yuiseki/exp-cubic-earth/simulate/README.md

# simulate

立方体の組み方を 3MF にして、3D ビューワーで見るためのスクリプト。寸法は `docs/DIMENSIONS.md`。

```sh
# 1. メーカーの STEP (ER-TFT040-3-6011.zip の中身) を、パネルと基板の STL に分ける (約 40 秒)
uv run --no-project --with gmsh --with numpy --with numpy-stl python step_parts.py ER-TFT040-3-6011.STEP

# 2. 2 つの山頂型モジュール (3 枚のパネルが 1 つの角に集まる形)で立方体を組み、合体と分解の 3MF を書く
uv run --no-project --with numpy --with numpy-stl python cube.py --fpc top=-y,A=-z,B=-z

# テスト
uv run --no-project --with numpy --with pytest python -m pytest -q test_geometry.py
uv run --no-project --with gmsh --with numpy --with numpy-stl --with pytest python -m pytest -q test_summit_frame.py
# 印刷用 STL (hardware/frame) が 1 つにつながった閉じた立体で、README の大きさと体積のとおりか
uv run --no-project --with numpy --with numpy-stl --with pytest python -m pytest -q test_frame_stls.py

# 3. 山頂型モジュールの Y 字の枠
uv run --no-project --with gmsh --with numpy --with numpy-stl python summit_frame.py
```

- 出力は `build/` (git に入れない。メーカーの 3D モデルから作った形を含むため)
- 1 つ目のモジュールは天面 (+z)、A (-y)、B (+x) の 3 面。2 つ目は同じモジュールを (1, 1, 0) の軸のまわりに半回転したもので、底面 (-z)、C (-x)、D (+y) になる
- `--fpc` は 1 つ目のモジュールの各面について、FPC の出る辺が向く方向 (世界の軸)。2 つ目は回転で決まる
- 面は FPC を折って基板をパネルの裏に重ねた状態 (基板は FPC の辺から 20mm)。FPC と FFC は箱で近似している。FFC は CON1 からパネルの辺の 2mm 先までを描く
- `--edge` を省くと、2 つの面の部品が重ならない最小の辺の長さ (向かい合うガラスの間) で組む。今は 6 面ともパネルの中心を立方体の中心から同じ距離に置くだけで、角で一方の面が他方の縁に重なる組み方はまだ入れていない
- 実行すると、各面の FFC がどの面の側へ出ていくかを表示する
- `cube.py --search` は、1 つ目のモジュールの 3 面の向き 64 通りについて、FFC の行き先、3 本とも自分のモジュールに留まるか、1 枚の面を角のまわりに 120 度ずつ回した形か (外から角を見て時計回りか反時計回りか)、最小の辺の長さ、FPC の辺 (ガラスの外に 2.81mm の縁がある辺) どうしが同じ稜に来る組の数 (`meetings`) を並べる。3 本とも留まるのは 8 通り、そのうち 120 度ずつ回した形は 2 通り (`top=-y,A=+x,B=+z` が時計回り、`top=-x,A=-z,B=+y` が反時計回り)。反時計回りの `top=-x,A=-z,B=+y` は、3 組とも FPC の辺がもう一方のモジュールの面の FPC の辺と同じ稜に来る (天面と C、A と底面、B と D)。時計回りの `top=-y,A=+x,B=+z` は 0 組だが、FFC がパネルの辺から出る所は角から約 57mm (反時計回りは約 25mm)。64 通りのうち 0 組は 20 通り
- `cube.py --module` は、1 つ目のモジュール (天面・A・B) だけを `build/module_<plan>.3mf` にも書く。立方体の筐体をモジュール単位で作るときの基準。角 (山頂) を真上に、FPC の辺がある縁を下にして立て、天面が手前 (-y) に傾く向き。いちばん低い点が z = 0 で、高さは約 88mm
- `summit_frame.py` は、山頂型モジュールの 3 本の継ぎ目 (天面/A、A/B、B/天面) に沿う、溝付きのまっすぐな棒 3 本を作る。棒の断面は L 字で、パネルごとにガラスの前の縁 (パネルの辺から `OVERLAP` = 1.0) と裏の壁 (`WALL_OVERLAP` = 3.0、厚み `BACK` = 1.2) があり、その間の溝 (2.18 + 両側 0.1 = 2.38) にパネルの辺が入る。2 本の溝が 90 度をなす。テープは使わず、前の縁だけでパネルを押さえる。山頂では 3 本が留め継ぎ (各点を、角から測ってより遠くまで伸びている継ぎ目の棒に入れる) で合わさる。モジュールは角のまわりに 1/3 回すと自分に重なるので 3 本は同じ形で、もう一方のモジュールも同じ。つまり 1 種類の棒を 6 本刷る。印刷は体積で課金され、Y 字につなぐと高さ 80mm ほどの印刷になるので、棒に分けて寝かせて刷る (82.7 x 7.5 x 7.5、1 本 1.96cm³)。基板・FPC・FFC の箱 (0.5 の余裕つき) は削ってある。FFC は継ぎ目まで行かずに内側へ折れる (実物で確認、2026-10-21) ので、CON1 からパネルの X = 68 まで進んで立方体の中心側へ 25mm 降りる箱で近似している。書くのは `build/summit_frame_bar<i>.step/.stl` (組んだ位置、立方体の中心が原点)、`build/summit_frame_bar0_print.stl` (縁の外の面を下に寝かせた 1 本)、モジュールの部品と合わせた `build/summit_frame_module_<plan>.3mf` (山頂を上)
- `cube.py --corner t,side,turn` は、各モジュールの角の内側に三角形の基板 (緑) を描く。対角線に垂直な正三角形で、3 枚のパネルの裏が出会う内側の角から t mm 中心寄り、一辺 side mm。turn = 0 で三角形の角がパネルどうしの継ぎ目 (FFC が出てくる所) を向き、turn = 60 で辺が継ぎ目を向く。厚みは基板 1.6 と部品 5.0 を中心側に取る。その位置で入る最大の大きさと、重なる部品を表示する (`corner_board.py`)
- `geometry.earth_turns(plan, face0="A")` は、各面に映す地球の面 (QSC の 0〜5、face0 の面から東へ 0〜3、天面が北極 4、底面が南極 5) と、その画像を時計回りに何回 90 度回すか (`lt7680_multi` の `x,n,r` の r) を返す。反時計回りの `top=-x,A=-z,B=+y` では 天面 (4,3)、A (0,0)、B (1,1)、底面 (5,2)、C (3,2)、D (2,3)
- 天面・A・B のモジュールに北極・アジア・アフリカを映すときは `face0="B"`: 天面 (4,2)、A (3,0)、B (0,1)、底面 (5,3)、C (2,2)、D (1,3)

## 溝のある棒と内側のコーナーブラケット (`summit_bars.py`)

山頂型モジュールの 3 本の継ぎ目に、溝のある角棒を 1 本ずつ通し、頂点の内側にコーナーブラケットを置く。透明な樹脂で印刷する前提。

```sh
uv run --no-project --with gmsh --with numpy --with numpy-stl python summit_bars.py
uv run --no-project --with numpy --with pytest python -m pytest -q test_summit_bars.py
```

- 棒は 6.88 x 6.88mm。断面に 2 本のスリット (幅 2.38mm、LCD 2.18mm に片側 0.1mm) があり、棒の中で交わらない。それぞれの LCD は外の面から 1.0mm 奥を通り、縁は相手の面から 4.38mm で止まる (くわえる深さ 2.5mm)。2 本のスリットの間に 1.0mm 残るので、棒は 1 本のまま。LCD の裏の壁は 1.2mm で、その先の内側の角は削る
- LCD は角で重ねない (風車にしない)。立方体の外の稜は、長いほうの LCD の辺 76.54mm に 4.38mm を 2 回足した 85.3mm
- 頂点では 3 本の棒の先端が斜め切り (どの点も、頂点から遠く伸びている継ぎ目の棒に属する) で合わさり、外の頂点を作る。3 本は同じ形
- コーナーブラケットは 3 枚の LCD の裏より内側だけにあり、外の面から 16mm までの立方体を、LCD の裏からの深さの和 26mm で四面体に切る。そこから棒の裏の壁を 0.1mm 太らせてくり抜くので、棒の端がブラケットのくぼみに収まる
- 組み方: 棒 3 本をブラケットに差す。そのあと LCD を 1 枚ずつ、その面の中で頂点に向かって斜めに押すと、2 本の棒のスリットに同時に入る
- 体積 (2026-10-28): 棒 1 本 2.48cm³、ブラケット 1.47cm³、1 モジュール約 8.9cm³。棒は外の面を下に寝かせて印刷する (`build/summit_bars_bar0_print.stl`)
- 出力: `build/summit_bars_bar<i>.stl/.step`、`build/summit_bars_bracket.stl/.step`、`build/summit_bars_module.3mf` (LCD と基板と並べたもの、頂点を上にして立てる)
- コーナージョイント (`joint_at`、`build/summit_bars_joint.stl`): 長い棒とブラケットの代わりに、頂点のまわりだけを押さえる 1 個の部品。3 本の棒を頂点から継ぎ目に沿って 20mm (`JOINT_ARM`) で切り、1 個につなげたもの。アクリルの十字コーナージョイント (3mm 板用) の立体交差版で、各腕に交わらない 2 本のスリットがある。1.43cm³、20mm 角に収まる。外の面を下に置いて印刷すると高さ 20mm
- 長い棒 (`long_bar_at`、`build/summit_bars_long_bar*.stl`): ジョイントの腕の先から継ぎ目の外周の端までの、同じ断面のまっすぐな棒。65.3mm、2.00cm³。腕と棒は突き合わせるだけで、LCD が両方のスリットを通るので向きがそろう。3 本は同じ形 (角のまわりに 3 分の 1 回すと移り合う、テストで確認)
- 採用した組み合わせはジョイント 1 個と長い棒 3 本 (1 モジュール約 7.4cm³)。LCD と並べたものが `build/summit_joint_module.3mf`
- 未決: モジュールどうしの継ぎ目 (外周の 6 本) と、棒の外周側の端の形

## 立方体全体の枠: 8 個のジョイントと 12 本の棒 (`cube_frame.py`)

`summit_bars.py` の断面のまま、8 個の頂点すべてにコーナージョイント (腕 20mm) を、12 本の稜すべてにジョイントの間の棒を置く。

```sh
uv run --no-project --with gmsh --with numpy --with numpy-stl python cube_frame.py
uv run --no-project --with numpy --with pytest python -m pytest -q test_cube_frame.py
```

- LCD は面の中央に置く。外の稜は長い辺 76.54mm に (4.38 + 0.1)mm を 2 回足した 85.5mm。長い辺はスリットの底の 0.1mm 手前、短い辺 (1.88mm 短い) は約 1mm 手前で止まり、くわえる深さは長い辺 2.4mm、短い辺 1.5mm
- スリットは LCD の大きさによらず、いつも底 (相手の面から 4.38mm) まで彫る。そのため棒 12 本は 1 つの形、ジョイント 8 個も 1 つの形で、どこに付けてもよい
- 枠が逃げるのは LCD の本体と基板だけ。FPC と FFC は曲がる配線なので、CAD では扱わない
- 体積 (2026-10-28): ジョイント 1.46cm³ x 8、棒 45.5mm 1.37cm³ x 12、全体 28.1cm³。どれも 1 個の固まりで閉じている (trimesh)
- 出力: `build/cube_frame_joint<n>.stl`、`build/cube_frame_bar<n>.stl` (立方体の中の位置)、印刷用に外の面を下に寝かせた `build/cube_frame_print/` (ジョイントは高さ 20mm、棒は 45.5 x 6.88 x 6.88mm)、LCD と並べた `build/cube_frame.3mf`
