yuiseki/exp-cubic-earth/tmp/HYPOTHESES.md

# 仮説の台帳 (ベイズ的に更新する)

対象の現象: 「パネル (ST7701S) の初期化は、動作中に命令として行うと高い確率で映る (37 回中 31 回、約 84%) のに、XIAO の起動時に同じ手順を行うと 1〜2 割しか映らず、電源の入れ直しでは 17:52〜18:11 の 3 回を除いて 11 回連続で映らない。」

確率は主観的な信念。観測ごとに、各仮説がその観測を予測していた度合い (尤度) で更新する。数値は粗い (0.1 刻み程度) が、方向と大きさを明示することが目的。

## 既知の観測 (TIMELINE.md より)

| 記号 | 観測 |
|---|---|
| O1 | LT7680 側は 17:07 以降一度も失敗していない |
| O2 | G の状態ではパネルへの命令 (反転、ソフトリセット、初期化) が届く |
| O3 | G からパネルに触らず XIAO をリセットすると 10/10 G のまま (XIAO 起動中 LT7680 はリセットされ、約 2 秒クロックが止まるのに) |
| O4 | 命令 #0 系 (LT7680 リセット 100ms → PLL/SDRAM → 表示オン → 塗り → SWRESET → 初期化) は 37 回中 31 回 G |
| O5 | 同じ手順を起動時に行う (ord 版) と 10 回中 1 回。8 秒待ってから行うと 11 回中 0 回 |
| O6 | V (LT7680 のリセット線を 1 秒浮かせ、LT7680 がでたらめにリセットされる → #0) は 8 回中 6 回 G |
| O7 | Y/Z (パネル SPI 線を 5 秒浮かせる。LT7680 は動き続ける) は 2/2 G のまま |
| O8 | 電源の入れ直し: 17:52、17:57、18:11 は G。以後 11 回は B (同一バイナリでも) |
| O9 | 焼き直しとリセットに差は見られない (19:54 焼き直し 5 回で G は 0) |
| O10 | P (白っぽく固まる) は電源の入れ直しでしか抜けない |
| O11 | D5 を入力にしてもパネルからの読み出しは無い (DIN は一方向) |

## 仮説と事前確率

| 記号 | 仮説 | 事前 | 根拠 |
|---|---|---|---|
| H_gap | 動作中のパネルが RGB クロックを長く (1 秒以上) 失った後は、ソフト初期化が通りにくく、失った時間が長いほど悪い。クロックを失うだけなら表示は保たれる (O3) が、その状態で初期化列を送ると壊れる | 0.30 | O4 (隙間 0.1 秒、84%) > O6 (約 1 秒、75%) > O5 (2〜5 秒、10%) > 8 秒版 (0%) と単調。O7 と矛盾しない |
| H_boot | XIAO の起動そのもの (ブートローダー中のピンの状態、USB 列挙の電流変動) がパネルを乱す | 0.20 | O5 と O9。ただし O7 (浮かせても壊れない) で弱い |
| H_por | 電源投入時のパネルの POR が電源の立ち上がり方で失敗する。電源の入れ直しの成否はファームと無関係 | 0.15 | O8 を説明。XIAO リセット時の挙動は説明しない |
| H_thermal | 基板かパネルが温まると初期化が通りにくくなる。成功が前半に集中 (O8、O4 の多くは 19:17 以前) | 0.15 | 時間による変化を説明。切り分けていない |
| H_initseq | 送っている初期化列やビットのタイミングが微妙に違い、確率的にしか通らない | 0.10 | 84% 通るので主因ではなさそう。vendorflow はメーカーと同じタイミング |
| H_other | 上記以外 | 0.10 | |

## 実験の計画と予測

| 実験 | 内容 | H_gap | H_boot | H_por | H_thermal | H_initseq |
|---|---|---|---|---|---|---|
| E1 | 命令 #G n: LT7680 をリセットに保ってクロックを n 秒止めてから #0 手順。n = 0.1, 1, 2, 4, 8 を数回ずつ。XIAO は再起動しない | n が長いほど失敗 | n に依らず約 84% | n に依らず約 84% | 温まっているなら全部低い | n に依らず一定 |
| E2 | E1 の n=2 と、esptool リセット (隙間約 2 秒 + XIAO 起動) を同じ回数比べる | 両方とも低い | リセットだけ低い | 両方高い | 両方低い | 両方同じ |
| E3 | 電源を 10 分以上切って冷ましてから入れる (本人の操作 1 回) | B (最近の 11 回と同じ) | B | B か G (確率) | G | B |
| E4 | 起動時の隙間を最小にする (delay(1500) を外し、起動直後に LT7680 を立ち上げる) でリセット ×10 | 改善 | 変わらない | 変わらない | 変わらない | 変わらない |

更新の記録は下に追記する。

## 更新 1: E1 の結果 (20:0x〜20:2x)

E1: G から始めて、LT7680 をリセットに保ちクロックを 0.1/1/2/4/8/16 秒止め、その後 #0 と同じ手順。14 試行中 14 試行 G (0.1 秒 ×4、2 秒 ×4、8 秒 ×3、16 秒 ×3)。XIAO は再起動していない。

副産物の観測 O12: リセット直後の動画で、B は「駆動されていない黒 (濃い青の画素 5,000〜9,000)」ではなく「同期は来ていて黒を表示している (約 21,000)」。パネルは RGB の同期を受け取っているが画素の値を無視して黒を出している。

| 仮説 | 事前 | 尤度 (E1) | 事後 |
|---|---|---|---|
| H_gap | 0.30 | 16 秒で 3/3 成功はほぼ起きない (約 0.05) | 0.03 |
| H_boot | 0.20 | 予測どおり (1.0) | 0.45 |
| H_por | 0.15 | 無関係 (0.5) | 0.17 |
| H_thermal | 0.15 | 3 時間稼働後に 14/14 なので低い (0.25) | 0.08 |
| H_initseq | 0.10 | 14/14 (0.15) | 0.03 |
| H_other | 0.10 | (1.0) | 0.24 |

H_boot の内訳 (次の実験で分ける):
- H_boot_pins: ブートローダー中にパネル SPI 線が浮き、その直後の初期化が失敗する → E5 (A: 3 本浮かせてから初期化) が失敗し、E6 (B: CS だけ High に保つ) が通る
- H_boot_usb: USB 再列挙に伴う 5V の揺れ → E7 (R: esp_restart、再列挙なし) が通る
- H_boot_rom: ROM が起動時にピンを駆動する → E7 が失敗し、E5/E6 が通る

## 更新 2: E5〜E12 (20:29〜21:16)

| 実験 | 内容 | 結果 |
|---|---|---|
| E5 (A) | パネル線 3 本を 5 秒浮かせてから初期化 | 通算 3/9 |
| E6 (B) | CS だけ High に保ち SCLK/DIN を浮かせてから初期化 | 2/4 |
| E7 (R) | esp_restart (USB 再列挙なし) で起動の流れ | 2/4 |
| E8 | B の状態で 0x13 NORON + 0x38 | 0/4 (全画素オフ/オン仮説は棄却) |
| E9 | #G0 (浮かせない) と #A を交互 | G0 5/5、A 2/5 (時間による劣化ではない) |
| E10 | 1 本だけ浮かせる: CS / SCLK / DIN | 3/3、1/3、3/3 (SCLK が原因) |
| E11/E12 | SCLK を浮かせた後の対策候補 | 対照 2/8、CS 上げ下げ 1/3、SWRESET x3 1/3、2 秒待ち 2/3、初期化列 2 回 8/8、SCLK 空打ち 1/3 |

結論 (信念 0.85): XIAO の起動中にパネル初期化用の SCLK (D4) が浮くと、その後の初期化列が 1 回では通らない (約 25〜35%)。初期化列を 2 回送ると通る (8/8)。機構は未解明 (CS は High なのに SCLK の浮きが効く。ソフトリセットでは直らない)。
電源投入時 (H_por) は未検証。起動の流れに「初期化列を 2 回」を入れた上で、電源の入れ直しで確かめる。

## 更新 3: 地球の描画と、起動の再検証 (21:17〜21:35)

判定器の訂正: 21:17 ごろからカメラの写りが変わり、黒いパネルが濃い青 (約 69) でなく薄い色 (約 145) で写るようになった。青の数の差で判定する `kwjudge.py` はこれ以後あてにならない (「LIVE」と言った kw-rec1 と e2-pre は、白の明るさで見ると 145 = 映っていない)。以後は白で塗った写真のパネル領域の明るさ (`wjudge.py`、映れば 220 以上、黒や固まった画面は 150 以下) で判定する。E8〜E12 の写真を明るさで見直したところ結果は変わらなかった (更新 2 の結論は有効)。

| 観測 | 結果 |
|---|---|
| O13 | `#0` (命令、初期化 1 回) で G にした後の `#E` で、地球の QSC の面が映った (earth-cmdE2-1792067074.jpg) |
| O14 | lt7680_earth の起動の流れ (初期化 2 回 → 地球) は、esptool リセット 0/5、esp_restart (#R) 0/3。シリアルは毎回 INIT OK、init twice、描画 4109 ms まで出る |
| O15 | 起動に失敗した直後の `#0` は 2/2 で G |

更新 2 の「初期化列を 2 回で通る (m4 8/8)」は、SCLK だけを浮かせた命令でのこと。本物の起動 (全部の線が浮く、バックライトが消えている、初期化直後に地球を描く) では 0/8。
E13: これらを命令 #F<v> で模倣して切り分ける (v のビット: 1=SCLK だけ浮かせる、2=バックライトは点けたまま、4=地球を描かない。F0 = 起動そっくり、F7 = m4 と同じ)。

## 更新 4: 起動の流れを 2 回 (21:38〜22:07)

| 実験 | 内容 | 結果 |
|---|---|---|
| E14 | 起動の条件を命令 #F<v> で模倣 (完了行を待ってから判定、15 秒後にも判定) | F0 1/2、F1 0/2、F2 2/2、F4 2/2、F7 1/2 (合計 6/10)。本物の起動 (0/8) ほど悪くない。判定が遅れて変わった例は無し |
| O16 | setup の先頭で IO_MUX を読んだ。リセット直後は D0〜D10 すべて wpu=0 wpd=0 (浮いている)。模倣の INPUT と同じ | H_pullup (リセット中は内蔵プルアップ) は棄却 |
| E15 flows2 | 起動時に「LT7680 リセット → PLL/SDRAM → 表示オン → 塗り → SWRESET + 初期化 ×2」の流れ全体を 2 回 | esptool リセット 10/10 |
| E15 flows2-init1 | 流れ全体 2 回、各流れのパネル初期化は 1 回 | 4/5 |

結論 (信念 0.9): XIAO の起動後、最初の流れ (LT7680 のハードリセットを含む) では映らず、2 回目の流れで映る。`#0` が 84% 通っていたのは、命令はいつも「2 回目以降の流れ」だったから。パネル初期化列を 2 回にするのは補助で、流れを 2 回にすることが本体。機構は未解明 (LT7680 の最初のリセット後に何かが安定していない、またはパネルの RST が LCM_RESET と共通で最初のリセットの効き方が違う、など)。
H_por (電源投入) は未検証。本人に USB-C の抜き差し 3 回を依頼する。

## 更新 5: 電源投入 (E16、2026-10-16 05:48〜05:55)

本人の報告: 流れ 2 回の版 (fb1c7cd) で USB-C の電源投入 3 回とも映らず。その数時間後に `#0` を送ると映った (LIVE)。

E16: 起動後 0、5、10、20、40、80 秒に流れを 1 回ずつ行い毎回白で塗る診断版で、本人が電源投入を 1 回。カメラの 2 秒ごとの撮影:
- 挿した 3 秒後 (最初の流れの完了直後) に白 (W=222) → 映った
- 5 秒の流れの途中 (LT7680 リセット) で暗くなり、以後 10/20/40/80 秒の流れを経ても黒のまま (W=73)
- シリアルは 6 回の流れとも lt7680 OK、reset reason 1 (power on)

| 観測 | 内容 |
|---|---|
| O17 | 電源投入では最初の流れで映る (1/1)。2 回目の流れが壊し、続く 4 回では戻らない |
| O18 | XIAO だけのリセットでは最初の流れで映らず 2 回目で映る (E15、10/10) |
| O19 | 流れ 2 回の版は電源投入で 0/3 (O17 と整合: 2 回目が壊す) |

当面の対処 (機構は未解明): reset reason が POR なら流れ 1 回、それ以外なら 2 回 (`BOOT_FLOWS_POWERON 1`、`BOOT_FLOWS 2`)。esptool リセットでは 2 回の経路が動くことを確認済み。電源投入 3 回の確認は本人に依頼。
「1 回目は映り 2 回目で壊れる」と「1 回目は映らず 2 回目で映る」を一つで説明する仮説は未着手。候補: 流れが状態を反転させる (偶奇) が、`#0` を G から送った 84% の観測と合わない。

更新 5 の追記: 流れ 1 回 (POR) の版でも本人の電源投入 3 回とも映らず (0/3)。E16 の「最初の流れで映る」は 1/1 で、再現しない。電源投入の正常系は未確立。

## 更新 6: 電源投入の直接測定 (E17〜E19、2026-10-16 06:00〜06:23)

- 映る状態と映らない状態で LT7680 のレジスタ 0x00〜0xFF を全部読み比べて完全に同一 (STSR も 0x50)。差は LT7680 の設定にはない
- E17/E18: 1 回流しの版での XIAO リセットが今日は 11/11 映る (昨夜は 0/8)。#y で映らない状態を作ってからリセットしても 3/3 映る。H_prev (前の状態が残る) は棄却。昨夜との違いは未特定
- E19 (電源投入、本人 1 回、診断版 0 秒と 30 秒に流れ、カメラ 2 秒ごと): 0 秒の流れも 30 秒の流れも黒のまま (E16 で見えた一瞬の白は再現せず)。LT7680 はリセット解除 4 ms で inhibit が落ち STSR=0x50。挿してから 133 秒後に `#0` を送ると映った (LIVE)
- 残る仮説: H_time (電源投入から約 2 分以上経てば流れが通る) と H_count (3 回目以降の流れが通る)。E20 の診断版 (0、3、6、9、150 秒に流れ) で分ける

## 更新 7: E20 (電源投入、本人 1 回、流れを 0/3/6/9/150 秒に)

挿してから 0、3、6、9 秒の流れはすべて黒。150 秒の流れで白 (挿してから 154 秒で W=218、以後持続)。LT7680 は毎回 4 ms で ready。
→ H_count (回数) は棄却。H_time (電源投入から約 2 分以上経つと流れが通る) を採用 (信念 0.8)。しきい値は 80 秒 (E16 で失敗) と 150 秒の間。
次: 流れを 150 秒に 1 回だけ (それまで LT7680 もパネルも触らない) で、「時間」だけで足りるのか、先行する流れ (クロックが出ている状態) が要るのかを分ける。

## 更新 8: 電源投入の自動運転 (E21〜変種 3、2026-10-16 06:33〜06:52)

本人の負担を減らすため、`cycle_runner.sh` で「ビルド → 焼く → ntfy で抜き差しを依頼 → 抜き差しを検知 → 200 秒間 2 秒ごとに撮影 → 最初に白くなった秒数を判定 → ntfy で結果」を自動化した。本人は ntfy が来たら抜き差しするだけ。

| 電源投入 | 起動後の操作 (秒) | 結果 |
|---|---|---|
| E16 | 流れ 0,5,10,20,40,80 | 全部黒 (最初の流れ直後に 1 コマだけ白、再現せず) |
| E19 | 流れ 0,30 → 133 秒に `#0` | 133 秒で映る |
| E20 | 流れ 0,3,6,9,150 | 150 秒で映る |
| E21 | 流れ 150 のみ | 黒 |
| 変種 1 thr | 流れ 0,60,90,120,150 | 全部黒 |
| 変種 2 ltonly | 0 秒は LT7680 だけ (PLL/SDRAM/表示オン/塗り、パネル初期化なし)、150 秒に流れ | 黒 |
| 変種 3 one150 | 流れ 0,150 | 151 秒で映る |

LT7680 は毎回リセット解除 4 ms で inhibit が落ち、STSR=0x50。流れの中の LT7680 側は常に正常。

### 仮説の更新

| 仮説 | 内容 | 判定 |
|---|---|---|
| H_count | 3 回目以降の流れが通る | 棄却 (変種 1 で 5 回目も黒) |
| H_time | 電源投入から約 2 分で流れが通る | 棄却 (E21、変種 2) |
| H_prev | 直前の状態が残る | 棄却 (E18) |
| H_pullup | リセット中の内蔵プルアップ | 棄却 (O16) |
| H_gap (LT7680 の連続稼働時間) | クロックが T 秒以上出ていれば通る | 棄却 (変種 2) |
| H_gap2 | 電源投入後、パネル初期化を含む流れを一度行い、その後 T 秒以上 (60 < T ≤ 103) 空けてから流れを行うと映る。間隔が短いと通らず、先行の流れが無いと通らない | 電源投入 7 回すべてと整合 (信念 0.75) |

H_gap2 で説明できないもの: XIAO だけのリセットでの挙動 (昨夜: 1 回流し 0/8、2 回流し 10/10。今朝: 1 回流し 11/11)。2 回流しの 2 回目は 200 ms 後なのに通る。電源投入と XIAO リセットでは別の機構が働いている可能性が高い。XIAO リセットの昨夜と今朝の差も未特定。

### 機構の候補 (未検証)

- パネルの RST が基板上で LCM_RESET と共通で、電源投入後の最初の SWRESET + 初期化列が ST7701S の何か (電荷ポンプ、ガンマ、バンク選択) を「半分だけ」進め、T 秒後の再初期化で完了する
- ST7701S の内部電源 (VCOM、AVDD) の立ち上がりが初期化列の後に完了し、完了前の再初期化は壊す

### 次の実験 (本人の選択待ち)

- A: T を詰める (流れ 0,120 → 0,90 → 良い方を 2 回再現)
- B: 150 秒で固定し、地球版 (流れ 0 → 150 秒 → 流れ → 地球描画) を作って再現 2 回

## 更新 9: H_gap2 (one150) の再現試験 rep150 (2026-10-16 06:55〜07:11)

条件: 同一バイナリ (58caab85、`-DBOOT_DIAG=1 -DBOOT_DIAG_AT=0,150000`)。cold boot (USB-C の抜き差し) → t=0 に流れ (LT7680 リセット → PLL/SDRAM → 表示オン → 白で塗る → SWRESET + 初期化列 ×2) → 150 秒間は LT7680 にもパネルにも何も送らない → t=150 秒に同じ流れ → 計測後に `#W` で白を塗り wjudge で判定 → LIVE のときだけ `#E` で地球を描いて撮影。ハード・配線・初期化列・SPI 速度・ピン設定は変更していない。`cycle_runner2.sh` が抜き差しを検知し、2 秒ごとに撮影した。

### 観測事実

| 試行 | USB 再接続 | reset reason | 流れ 1 (start → done, STSR) | 流れ 2 (start → done, STSR) | `#W` 後の W | 判定 |
|---|---|---|---|---|---|---|
| 1 | 06:55:41 | 1 (power on) | 1511 → 2638 ms, 0x54 | 150008 → 151135 ms, 0x54 | 204 (173 秒) | LIVE。地球を描いて撮影 (rep150-1/earth.jpg) |
| (2 初回) | 06:59:28 | 1 (power on) | 1511 → 2638 ms, 0x54 | 150008 → 151135 ms, 0x54 | 撮れず | 未判定 (Web カメラが 114 秒ごろ USB から消えた。rep150-2-unjudged/) |
| 2 | 07:04:13 | 1 (power on) | 1511 → 2638 ms, 0x54 | 150008 → 151135 ms, 0x54 | 83 (174 秒) | BLACK (全区間 W=83) |
| 3 | 07:07:32 | 1 (power on) | 1511 → 2638 ms, 0x54 | 150008 → 151135 ms, 0x54 | 83 (174 秒) | BLACK (全区間 W=83) |

- LIVE の試行 1 では、2 回目の流れの直後 (挿してから 163 秒の撮影) から白 (W=205) が持続した
- 3 試行とも LT7680 の挙動 (リセット解除 4 ms、流れの所要時間、STSR) は同一
- 結果: 1/3 (判定できた 3 回のうち 1 回)。同じ手順の変種 3 one150 (06:48) も含めると 2/4

### 判定 (事前に決めた基準)

1/3 なので、one150 は正常系の候補として弱い。しきい値 T の探索には進まない。

### 推測 (事実と分けて書く)

- 変種 3 と試行 1 の成功は、H_gap2 の「間隔 ≥ T」だけでは決まらない確率的な事象だった可能性が高い
- 別のエージェントの指摘 (150 秒待つ LCD の仕様は無い。ST7701S の RESX を XIAO から操作できず、電源投入時の RESX が保証されていない可能性) は、この結果と矛盾しない。ただし手元の資料に ER-PCBA5981-1 の回路図は無く、CON2 の 6 番 (パネル RST) が LCM_RESET と共通か、RC か、未接続かは未確認。メーカーのデモは LCM_RESET の HW_Reset しかしていないので、基板上で何らかの処理はされているはず
- 次に価値が高いのは、テスターで CON2 の 6 番と CON1 の 11 番 (LCM_RESET) の導通を 1 回確かめること (本人の操作)

## 更新 10: POR → 自己再起動 → 初期化 (selfrestart、2026-10-16 07:15〜07:21)

別エージェントの提案: cold boot ではパネルにも LT7680 にも触らず 2 秒待って esp_restart() し、2 回目の起動 (reset reason 3 = software) で通常の初期化を行う。本人の操作は USB-C を挿すだけ。
実装: `-DBOOT_POR_SELF_RESTART=2000`。2 回目の起動は既定の非 POR 経路 (流れ 2 回、昨夜の esptool リセットで 10/10 だった経路) → 地球描画 → バックライト。バイナリ ec4f3e76。判定は挿してから 40 秒後に `#W` → wjudge。

### 観測事実

| 試行 | USB 再接続 | reset reason | バックライト点灯 (W の変化) | `#W` 後の W | 判定 |
|---|---|---|---|---|---|
| 1 | 07:16:16 | 1 → 3 | 約 12 秒 | 84 (49 秒) | BLACK |
| 2 | 07:17:41 | 1 → 3 | 同様 | 黒 | BLACK |
| 3 | 07:19:30 | 1 → 3 | 同様 | 黒 | BLACK |

結果 0/3。自己再起動は 3 回とも起きている。撮影失敗なし。

### 推測

- 「XIAO の warm reset 後に初期化すれば通る」は cold boot には当てはまらない。昨夜 esptool リセットで 10/10 だったのは、パネルがそれ以前 (何時間も前) の電源投入から通電し続けていた状態での話
- 電源投入からの経過時間 (数秒) で決まる要素が残っていることと整合する。ソフトだけで制御できる変数は尽きつつある

## 2026-10-16 07:28: メーカーへの問い合わせ

本人が BuyDisplay (sales@buydisplay.com) に、ER-PCBA5981-1 の CON2 6 番 (パネル RST) の扱い (LCM_RESET との接続、RC/リセット IC/プルアップの有無)、推奨の電源投入とリセット手順、回路図の提供を問い合わせた。原文は tmp/email/ (非公開)。回答待ち。回答が来るまで RST 周りの推測は確定させない。

## 更新 11: lt7680_multi (流れ 2 回、POR の特別扱いなし) の cold boot (2026-10-16 08:05〜08:09)

本人が「今のファームで USB-C を挿し直すと地球が出る」と観測したため、同じバイナリのまま自動運転で 3 回。判定は挿してから約 49 秒後の `#W`。

| 試行 | 再接続 | `#W` 後の W | 判定 |
|---|---|---|---|
| 1 | 08:05:38 | 103 | BLACK |
| 2 | 08:06:58 | LIVE | LIVE (地球の写真あり) |
| 3 | 08:08:12 | LIVE | LIVE (地球の写真あり) |

観測事実: 2/3。手順は lt7680_earth の「流れ 2 回」(fb1c7cd、本人目視で 0/3) と同じ内容。
推測: 電源投入の成功率は 0〜2/3 の間で揺れており、ファームの違いより制御できていない変数 (電源の履歴、パネルの状態) の影響が大きい。「確実に出る」手順はまだ無い。

## 更新 12: メーカー回答 (2026-10-16 10:26 CST 受信)

### 事実 (メーカー回答と添付の基板図)

- CON2 6 番 (パネル RST) は RC リセット。R9 10kΩ が LT768_VDD3.3V (基板の 3.3V) と RST の間、C27 1µF が RST と GND の間。リセット IC やダイオードは図に無い
- LCM_RESET (CON1 11 番) とはつながっていない。マイコンから RST を操作する手段は無い
- 推奨手順: 電源投入後 20〜30ms 待って RC リセットの完了を待ち、それから ST7701S を初期化する

### 推測

- 時定数は 10ms。今のファームは初期化の開始が電源投入から数百 ms 以上後 (XIAO の起動 + LT7680 の初期化) なので、推奨の待ち時間は毎回すでに満たしている。待ち不足は cold boot の不安定の説明にならない
- 「RST が LCM_RESET と共通かも」は否定された。H_resx (RESX を操作できない) は事実になった
- 放電用ダイオードが無い RC リセットは、電源が完全に落ちきる前に再投入されると C27 が放電しきらず、RESX が十分に Low にならない (パネルの POR が不完全になる) ことがある。抜いている時間が試行ごとに違えば成功率の揺れを説明できる。ただし今の記録には抜いていた時間が無く、確かめていない
- 確かめ方 (ハードウェア変更なし): 抜き差しの検知で「抜けた時刻」も記録し、抜いている時間を短い (1 秒) と長い (30 秒以上) に分けて成功率を比べる

## 更新 13: メーカー推奨どおりの最小起動 (BOOT_MINIMAL、2026-10-16 20:09〜20:13)

条件: lt7680_multi を `-DBOARD_SELECT_DIRECT=1 -DBOOT_MINIMAL=1` でビルド (f4f6ab2、バイナリ f1ff9c1e)。setup の先頭でパネル線を固定し、millis() が 30ms になるまで待ち、LT7680 のリセットと初期化、ST7701S の初期化 1 回 (SWRESET なし)、表示オン、地球。順序はメーカーのデモ CTP_test.ino と同じ。追加の待ちと流れの繰り返しは無し。抜いていた時間は cycle_runner3.sh (pi5-deck でデバイスが消えてから戻るまで) で記録。

### 事実

| 試行 | 再接続 | 抜いていた時間 | LT7680 初期化 | パネル初期化 | STSR | `#W` 後の W | 判定 |
|---|---|---|---|---|---|---|---|
| 書き込み直後 (esptool リセット) | 20:09:24 | なし | | | | 104 | BLACK |
| 1 | 20:10:01 | 7.6 s | 30→243 ms OK | 243→425 ms | 0x54 | 105 | BLACK |
| 2 | 20:11:13 | 7.7 s | 30→243 ms OK | 243→425 ms | 0x54 | 105 | BLACK |
| 3 | 20:12:35 | 14.4 s | 30→243 ms OK | 243→425 ms | 0x54 | 107 | BLACK |

cold boot 0/3。millis() はアプリの開始からの時間で、電源投入からはこれに ROM とブートローダーの時間が加わる。

### 推測

- 「余計な待ちと繰り返しを捨ててメーカー推奨どおりにすれば cold boot が安定する」は否定された。RC リセットの完了 (20〜30ms) を待つことは満たしたうえで 0/3
- 抜いていた時間は 7.6〜14.4 秒あり、1µF を 10kΩ と基板の負荷で放電するには十分と考えられる。この 3 回については「C27 が放電しきらず POR が不完全」は説明にならない (短い抜き差しの比較はしていない)
- 1 回の初期化では通らず、繰り返すと通ることがある、というこれまでの傾向と整合する。パネルが初期化列を受け付ける状態に入る条件が、推奨手順の外にある

## 更新 14: パネル線の基板側プルの有無 (2026-10-16 20:3x、命令 #P)

### 事実

- 動作中に 1 本ずつ XIAO の内蔵プルダウン (約 45kΩ) とプルアップを掛けて読んだ。LCD_CS (D2)、LCD_SCLK (D4)、LCD_DIN (D5) とも、プルダウンで 0、プルアップで 1。内蔵プルに勝つ強さ (数十 kΩ 以下) の外部プルは基板側に無い
- O16 (setup 先頭の IO_MUX) と合わせると、電源投入から setup までの間、3 本とも電気的に浮いている (100kΩ 級の弱いプルの有無までは分からない)。LCD_CS の D2 は ESP32-S3 の GPIO3 (ストラップピン)

### 推測

- 別エージェントの仮説「パネルの RC リセット解除 (20〜30ms) の時点で LCD_CS が High と保証されていない」は前提として成り立つ
- ただし反対方向の観測もある: E6 (CS を High に保ち SCLK/DIN を浮かせる) 2/4、E10 (SCLK だけ浮かせる) 1/3。仕様上 CS が High なら SCLK は無視されるはずなのに、CS High でも SCLK の浮きが効いていた。CS のプルアップだけでは足りない可能性がある
- 検証にはハードウェアの変更 (外付けプルアップ) が要り、本人の方針 (配線を変えない) の判断が必要

## 2026-10-16 夜: 本人の観測

- 事実 (本人の目視): 今のファーム (lt7680_multi、流れ 2 回、850000e) で USB-C を抜き差しすると、3 回に 1 回くらい地球が出る
- 推測: 同じバイナリ・同じ手順で成否が分かれるので、決まった待ち時間や順序の不足ではなく、毎回変わるもの (浮いている線のノイズ、電源の立ち上がり方) で決まる、という見方と合う。更新 14 の「浮いた線と RC リセット解除の競合」はこの性質を説明できる候補の一つ

## 更新 15: 原因は LCD_CS の線が外れていたこと (2026-10-16 夜)

### 事実

- 本人が配線を確かめたところ、D2 には何も挿さっていなかった。ファームウェアと WIRING.md は D2 = LCD_CS (CON1 16 番) を前提にしていた
- D2 と CON1 16 番をつなぐと、USB-C の抜き差しで地球が 100% 映るようになった (本人の目視。回数は未記録)
- いつ外れたかは分からない (本人「配線をごちゃごちゃいじった後」)

### 推測

- パネルの CS が浮いていると、XIAO の初期化列が届くかどうかは CS の線が拾う電位次第になる。成否が毎回揺れたこと、2 回目の流れや繰り返しで通りやすかったこと、SCLK を浮かせると悪化したこと (CS が実際には High でなかったため SCLK の雑音がそのまま取り込まれた) は、これで説明できる
- 更新 1〜14 の数字と結論 (流れ 2 回、150 秒、RC 放電、競合仮説など) は、外れていた期間にどこまで重なるか分からないので、根拠として使わない。#P の「LCD_CS に外部プル無し」も、線がつながっていない状態で測ったもので、基板側の事実としては無効
- 教訓: 電気的に説明しにくい揺れが出たら、仮説を重ねる前に、実物の配線を本人と 1 本ずつ照合する

- 追記 (本人の目視): LCD_CS をつないだ状態で、lt7680_multi の既定ビルド (流れ 2 回) の USB-C 抜き差しは 5/5 で地球が映った
- 追記: LCD_CS をつないだ状態で BOOT_MINIMAL (dac32ded) を cold boot。自動判定 3/3 LIVE (W=202〜204、抜いていた時間 2.2/3.2/4.7 秒、パネル初期化はアプリ開始から 243〜425ms)。本人の目視でも全回映った。4、5 回目の自動判定は本人の確認で足りたので打ち切った。更新 13 の BOOT_MINIMAL 0/3 は LCD_CS が抜けていたため

## 更新 16: 画素のバースト 10MHz の再試験 (2026-10-16 20:46〜、LCD_CS 接続済み)

- 事実: `-DBOOT_MINIMAL=1 -DPIXEL_SPI_HZ=10000000` (142154ee) を esptool リセットで起動。`#E` (10MHz で地球) → `#W` (白) を 10 回、白の判定 10/10 LIVE (W=202〜205)、地球の書き込みは毎回 776 ms (1MHz では約 4.1 秒)。写真の地球に色化けは見えない。本人も「描画がめちゃくちゃ早くなった」と目視
- 推測: 10/15 の「10MHz でパネルが止まる」は LCD_CS が抜けていたための揺れを 10MHz のせいと取り違えたもの。776 ms で 10 倍にならないのは、64 バイトごとに 1MHz で状態を読んでいるため

## 更新 17: 20MHz と全画素の照合 (2026-10-16 20:52〜21:15)

### 事実

- 20MHz (fbb65394): 地球の書き込み 588 ms、`#E`→`#W` 10 回で白 10/10 LIVE。写真に化けは見えない
- 命令 `#V` (表示用メモリを全画素 1MHz で読み返して照合、14.9 秒) を追加。20MHz で書いた直後 8 画素が不一致、すぐ読み直すと 24
- 命令 `#S<MHz>` で画素の速さを切り替え、`#K`→`#E`→`#V`→`#V` を比べた: 1MHz 23→40、10MHz 18→40、20MHz 18→39。不一致はどれも 1 ビットが 0→1 (0x0200、0x0400、0x4000 など上位バイト)、同じ位置が繰り返し出る
- `#V` を続けると 45、51、54、61 と増えた
- SDRAM のリフレッシュ間隔を LCD.cpp と同じ 486 (以前は 0x61A = 1562) にしても、6→26→34→41→45→53 と同じように増えた
- 書いてから 90 秒何も読まずに置いて読むと 7、続けて読むと 28

### 推測

- SPI の速さは化けと関係ない。20MHz の書き込みは 1MHz と同じ品質
- 化けを増やしているのは時間ではなく読み返し。最初の 6〜8 も、同じ読み返しの途中で起きている可能性があり、書き込みが完全かどうかはこの方法では確かめられない
- リフレッシュ間隔の仮説は棄却。値はメーカーに合わせた 486 のまま残す (効果は観測されていない)
