yuiseki/exp-cubic-earth/hardware/frame/bar-deep.stl

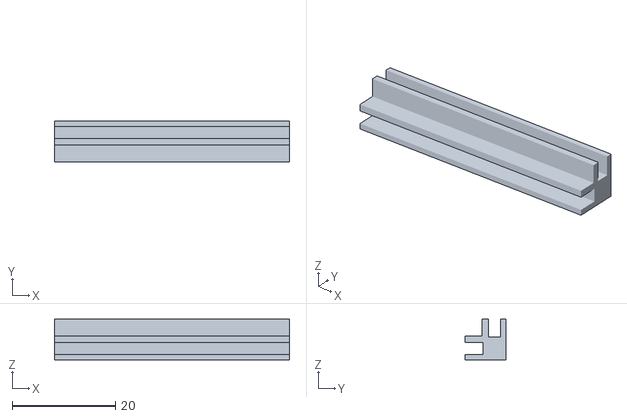
[picture p1: CAD file, 2026-11-08]
hardware/frame/bar-deep.stl
45.5 x 7.88 x 7.88
