yuiseki/exp-cubic-earth/hardware/frame/joint-deep.stl

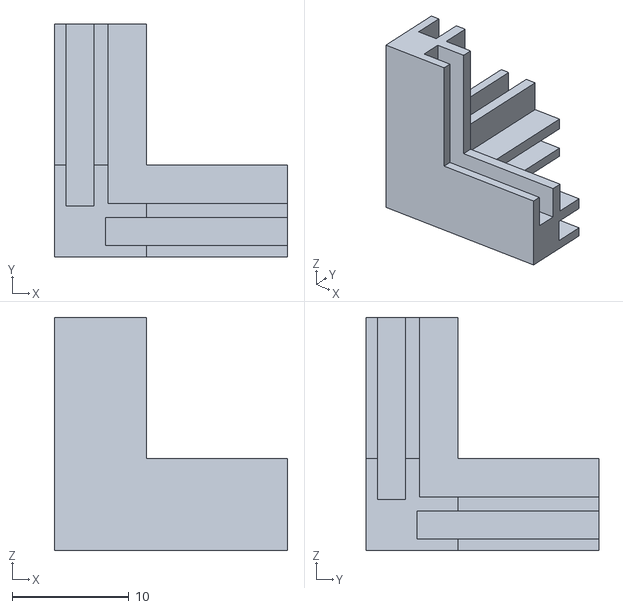
[picture p2: CAD file, 2026-11-08]
hardware/frame/joint-deep.stl
20.0 x 20.0 x 20.0
