yuiseki/exp-cubic-earth/hardware/frame/joint.stl

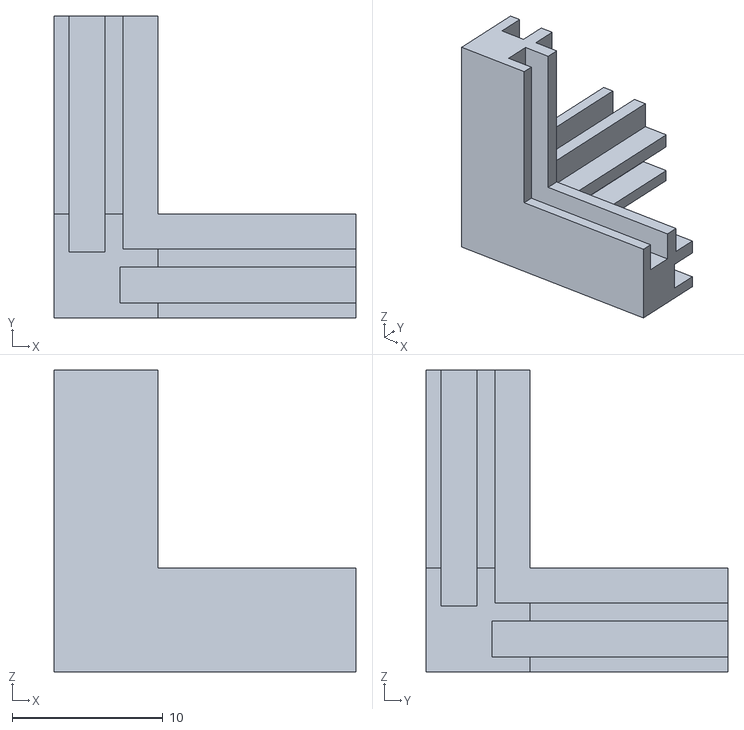
[picture p3: CAD file, 2026-10-28]
hardware/frame/joint.stl
20.0 x 20.0 x 20.0
