yuiseki/exp-cubic-earth/hardware/frame/bar.stl

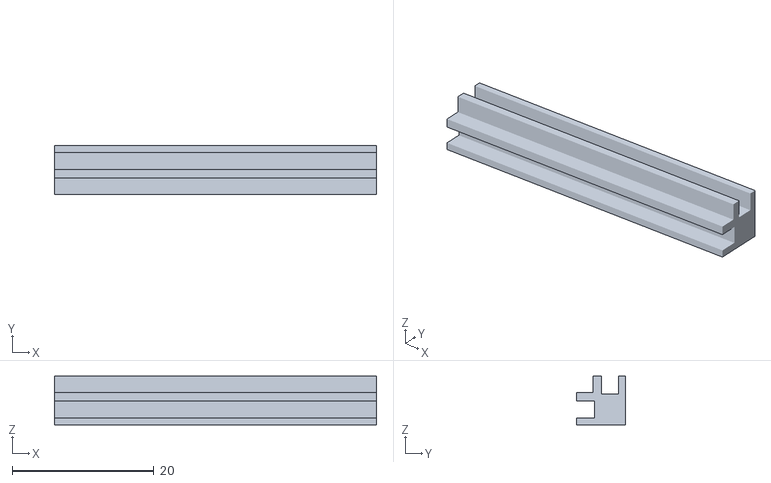
[picture p4: CAD file, 2026-10-28]
hardware/frame/bar.stl
45.5 x 6.88 x 6.88
