yuiseki/exp-cubic-earth/WIRING.md

# 配線: XIAO ESP32-S3 と ER-PCBA5981-1 (LT7680A-R) + ER-TFT040-3

動いている構成は 3 つある。どれも USB-C を挿すたびに地球が映る。

| | 構成 1: 直結で 1 枚 | 構成 2: 74HC138 で 2 枚 | 構成 3: 74HC138 で 3 枚 |
|---|---|---|---|
| 枚数 | 1 | 2 | 3 |
| CS の出し方 | XIAO の D0、D2 から直接 | XIAO の D0/D2/D6 で TC74HC138AP の番地を選び、その出力を CS に | 構成 2 と同じ。74HC138 の出力を 2 本足す |
| ファーム | `lt7680_multi` を `-DBOARD_SELECT_DIRECT=1` で (`lt7680_earth` も同じ配線) | `lt7680_multi` を `-DNUM_BOARDS=2` で | `lt7680_multi` を `-DNUM_BOARDS=3` で |
| 電源投入から全部映るまで | 約 1 秒 | 約 1.8 秒 | 約 2.6 秒 |
| 確認 | 2026-10-16 | 2026-10-18 | 2026-10-18 |

ビルドと命令は `lt7680_multi/README.md`。

## 共通

### 経路

XIAO ESP32-S3 (Sense でないもの) → デュポン線 → 変換基板「FPC-20P 1.0MM / 0.5MM」の 2x10 ピンヘッダ → 1.0mm 20 ピン FFC → ER-PCBA5981-1 の CON1 → (基板上の CON2 の FPC) → ER-TFT040-3

変換基板のピンヘッダの番号と CON1 の番号は、そのまま一致する (変換基板 j 番 = CON1 j 番)。

### どちらの構成でも XIAO から直接つなぐ線

2 枚以上のときは、全基板の同じ番号どうしをつないで共有する (CON1 の 1〜4、6〜9、11、18、19)。

| XIAO | CON1 | 信号 | 用途 |
|---|---|---|---|
| GND | 1, 2 | GND | |
| 5V | 3, 4 | VDD | 基板の電源 (動作範囲 3.3 から 5.0V)。基板上で 3.3V を作る |
| D9 (MISO) | 6 | LCM_SDO | LT7680 の SPI |
| D10 (MOSI) | 7 | LCM_SDI | LT7680 の SPI |
| D8 (SCK) | 8 | LCM_SCLK | LT7680 の SPI |
| D3 | 9 | BL_CONTROL | バックライト (出荷時の J1 短絡で外部信号が点灯を制御) |
| D1 | 11 | LCM_RESET | LT7680 のリセット。open drain + XIAO の内蔵プルアップ |
| D5 | 18 | LCD_DIN | パネル (ST7701S) の初期化用 3 線 SPI のデータ |
| D4 | 19 | LCD_SCLK | パネルの初期化用 3 線 SPI のクロック |

残りの CON1 5 番 (LCM_SCS、LT7680 の SPI の CS) と 16 番 (LCD_CS、パネルの初期化用 SPI の CS) のつなぎ方が、構成ごとに違う。

### パネルのリセット

パネルの RST (CON2 の 6 番) は CON1 に出ていない。基板上の RC リセット (R9 10kΩ で基板の 3.3V へ、C27 1µF で GND へ) だけにつながっていて、電源投入から 20〜30ms で解除される (メーカー回答)。XIAO から操作する線は無い。

### 起動の手順

メーカー推奨どおりで映る: 電源投入から 30ms 以上待つ → LT7680 のハードリセットと初期化 (PLL、SDRAM、表示タイミング) → ST7701S の初期化列を 1 回 → LT7680 の表示オン → 描画。`lt7680_multi` の既定の起動がこの手順で、2 枚のときは LCM_RESET を全基板一度に出したあと、基板ごとに初期化から描画までを順に行う。

## 構成 1: XIAO ESP32-S3 直結で 1 枚

共通の表に、CS の 2 本を足す。

| XIAO | CON1 | 信号 |
|---|---|---|
| D0 | 5 | LCM_SCS |
| D2 | 16 | LCD_CS |

D6、D7 は空き。電源投入から地球まで約 1 秒。USB-C の抜き差しで 4/4 映った (2026-10-16 夜)。

## 構成 2: XIAO ESP32-S3 + 74HC138 で 2 枚

CS の 2 本を XIAO から直接でなく、3 to 8 デコーダー TC74HC138AP (DIP-16) の出力でつなぐ。XIAO が出す 3 ビットの番地で、8 本の出力のうち 1 本だけが Low になる。出力は負論理なので、そのまま CS につなげる。

### XIAO → TC74HC138AP

| XIAO | TC74HC138AP | |
|---|---|---|
| D0 | 1 (A) | 番地の bit 0 |
| D2 | 2 (B) | 番地の bit 1 |
| D6 | 3 (C) | 番地の bit 2 |
| GND | 4 (G2A)、5 (G2B)、8 (GND) | |
| 3.3V | 6 (G1)、16 (VCC) | |

### TC74HC138AP → 基板

| TC74HC138AP | つなぐ先 | 番地 (CBA) |
|---|---|---|
| 15 (Y0) | 基板 0 の CON1 5 LCM_SCS | 000 |
| 14 (Y1) | 基板 1 の CON1 5 LCM_SCS | 001 |
| 12 (Y3) | 基板 0 の CON1 16 LCD_CS | 011 |
| 11 (Y4) | 基板 1 の CON1 16 LCD_CS | 100 |
| 7 (Y7) | 未接続 | 111 (どれも選ばない、待機時) |

3 枚にするときは構成 3。

### この構成で確かめたこと (2026-10-18)

- 2 枚とも LT7680 が応答し、電源投入から 2 枚目の地球まで約 1.8 秒。USB-C の抜き差しで 3/3、2 枚ともすぐに映った
- LCM_SDO (MISO) を 2 枚で共有しても、状態の読みは化けなかった
- 片方を白・片方を黒に塗って入れ替えると入れ替わる (2 枚を別々に選べている)
- 電源は XIAO の USB から 2 枚分。余裕は測っていない

## 構成 3: XIAO ESP32-S3 + 74HC138 で 3 枚

構成 2 の配線に、基板 2 への 2 本を足す。基板 2 の CON1 のほかの線 (共通の表の 9 本) は、基板 0、1 と共有する。

| TC74HC138AP | つなぐ先 | 番地 (CBA) |
|---|---|---|
| 15 (Y0) | 基板 0 の CON1 5 LCM_SCS | 000 |
| 14 (Y1) | 基板 1 の CON1 5 LCM_SCS | 001 |
| 13 (Y2) | 基板 2 の CON1 5 LCM_SCS | 010 |
| 12 (Y3) | 基板 0 の CON1 16 LCD_CS | 011 |
| 11 (Y4) | 基板 1 の CON1 16 LCD_CS | 100 |
| 10 (Y5) | 基板 2 の CON1 16 LCD_CS | 101 |
| 7 (Y7) | 未接続 | 111 (どれも選ばない、待機時) |

Y6 (9 番) は空き。74HC138 の出力は 8 本なので、この割り当て (基板ごとに 2 本、待機に 1 本) では 3 枚が上限。

### この構成で確かめたこと (2026-10-18)

- USB-C の抜き差しで 3/3、3 枚ともすぐに映った (本人の目視)
- 3 枚とも、状態を 40 回読んで 40 回正しい値 (STSR=0x54、CCR=0xC8、DPCR=0x40)。MISO を 3 枚で共有しても化けない
- 電源は XIAO の USB から 3 枚分 (バックライト込み) で動いている。XIAO の起動理由に電圧低下 (brownout) は出ていない。基板側の 5V は測っていない
- つないだ直後は基板 2 だけ不安定だった (下の「はまったところ」)。配線を確かめ直したあとは再現していない

## はまったところ

- 3 枚目 (基板 2) をつないだ直後、基板 2 だけ起動時に LT7680 の初期化が「表示用メモリ準備完了」待ちで止まり、映らなかった。基板 2 の状態の読みは毎回ばらばらで、CCR (書いたら変わらないはずのレジスタ) まで 0xC1、0xC8、0xC9 と変わった。バックライト (D3) を消すと基板 2 だけリセット直後の値 (STSR=0x00、CCR=0xC1、DPCR=0x00) に戻り、点けると戻った。レジスタの SPI を 100kHz まで落としても変わらなかったので、信号の速さの問題ではない。本人が基板 2 の CON1 9、11、1、2 番を確かめ直したあと (配線の変更は無し) は再現しなくなった。どの接触が効いたかは切り分けていない。同じ症状が出たら、まずその基板の線を 1 本ずつ挿し直す。`#I` (選んだ基板だけ初期化し直す) で一時的には戻せる
- LCD_CS (D2 ↔ CON1 16 番) が抜けていても、LT7680 は普通に動き、パネルも 3 回に 1 回くらいは映る。2026-10-16 夜まで、これに気付かず電源投入の不安定を調べていた。パネルが映ったり映らなかったりしたら、まずこの線を確かめる。
- パネル初期化用の LCD_DIN と LCD_SCLK を、LT7680 の MOSI (D10) と SCK (D8) に相乗りさせると、パネルは真っ黒のままだった。別のピンに分けると映った。メーカーのデモ (ER-TFT040-3_ESP32_Tutorial) も別のピンにつないでいる。UART0 の D6/D7 は避けて D4/D5 にした。
- LCM_RESET には基板にプルアップが無い。線が浮くとノイズを拾い、LT7680 がほとんどの時間リセットされたままになる。XIAO の内蔵プルアップで High に保ち、オープンドレインで Low に引く。LT7680 自身もこのピンにリセットを出す (オープンコレクタ) ので、High を押し付けない。
- XIAO ESP32-S3 Sense では、D9 (MISO) が何をしても High に張り付いた。拡張ボードの microSD が D8/D9/D10 を共有しているためと考えられる。本体の回路図 (`202003753_XIAO ESP32S3 Sense_v1.5`) では、拡張ボードへの基板間コネクタ J3 (DF40C-30DP) の 2〜5 番に D2、D8 (SCK)、D9 (MISO)、D10 (MOSI) が出ていて、「SD Card」と書かれている。拡張ボードの回路図 (`XIAO_ESP32S3_ExpBoard_v1.0_SCH.pdf`、Seeed の wiki の「XIAO ESP32S3 Sense オープンソース資料」) では、microSD の CS は R12 (0Ω、実装) で GPIO21 (USER_LED) につながり、D2 へは R11 (DNP、未実装) なので D2 にはつながっていない。MISO、MOSI、CS には 4.7kΩ の引き上げ (JP3 経由で microSD 用の 3.3V へ)、MISO、SCK、MOSI には 22Ω の直列抵抗がある。CS が GPIO21 で別なので、回路の上では LT7680 と SPI を共有して使えるはずだが、上の「D9 が High に張り付いた」はこの回路図だけでは説明できず、原因は分かっていない。Seeed の wiki (`xiao_esp32s3_sense_filesystem`) は「microSD を使うと XIAO の SPI は同時に使えない」とし、拡張ボードの J3 のはんだパッドを切ると microSD が無効になる (出荷時はつながっていて有効) と書いている。回路図の JP3 は 4.7kΩ の引き上げの電源側にあり、wiki の J3 と同じものかは未確認。2026-10-20、Sense (拡張ボード付き、microSD カード無し) に `lt7680_multi` (構成 3) を焼くと、起動時に基板 0 と 1 の LT7680 が「表示用メモリ準備完了」を待ったまま (10 秒待っても) 来ず、基板 2 は通った (4 回中 4 回、0 と 1 のどちらかか両方)。起動後に `#I` で初期化し直すと通った。拡張ボードを外して USB-C を挿し直すと、リセット 3 回で 3 枚とも通った。拡張ボードを付け直して USB-C を挿し直しても、リセット 3 回で 3 枚とも通った (1 回だけ基板 0 で準備完了まで 191ms 待った。普段は 100ms 未満)。拡張ボードそのものは原因ではなさそうで、最初の失敗は配線の接触か、焼き替えた直後の電源の状態によるものと考えられるが、どれかは分かっていない。Sense でない XIAO を使う。
- FFC の接点の向きが変換基板か CON1 のどちらかで合っていないと、どこにも接触しない。そのとき LT7680 は無応答で、MISO は浮く。片側を裏返したら接触した。
- 接触しても GND が来ていない間は、信号線を High にするとチップの保護ダイオード経由で基板の電源の網と GND の網が持ち上がる。基板の GND (JP1 の 1 番) が XIAO の GND に固定されるのを確かめてから 5V をつなぐ。
- 線を足したときに D10 が緩み、LT7680 の書き読みが周波数に関係なくでたらめに化けた。値が化け始めたら、まず配線の緩みを疑う。
- 2026-10-15 に「画素を 10MHz で大量に送るとパネルが止まる」と見えたのは、LCD_CS が抜けていた時期の観測だった。つないだ状態では、画素のバーストを 10MHz にしても止まらない (地球の全面書き込みと白塗りを 10 回繰り返して 10/10、2026-10-16)。

## LT7680 の SPI について確かめたこと

- モード 3 (データシートの図 2-4)。モード 0、2、3 は 100kHz と 1MHz で書き読みが通り、モード 1 は通らなかった。
- 1 回の転送は 16 クロック。先頭 8 ビットが前置き (0x00 レジスタ番号を書く、0x80 データを書く、0x40 状態を読む、0xC0 データを読む)。
- 起動直後の STSR は 0x50 (書き込み FIFO 空、読み出し FIFO 空、通常動作、表示メモリは未初期化)。

## 網の確かめ方

`netfinder` で、ADC の D5 を基板上の網 (JP1 の穴) にクリップし、XIAO の各ピンを 1 本ずつ動かす。全部 High にして 1 本だけ Low にしたとき 0V まで引き下げられるピンが、その網に直結しているピン。

## JP1 の穴の並び

JP1 は CON2 側の角にある 7 個の穴。基板の縁に沿った 5 個が、角から 7、6、5、3、1。内側の 2 個は 4 と 2 で、3 と 1 の隣にある。1 番が VSS、6 番が 3.3V、7 番が LCM_RESET。
