yuiseki/exp-cubic-earth/hardware/hub3/hub3.kicad_pcb

## KiCad design hardware/hub3/hub3.kicad_pcb (2026-10-23)

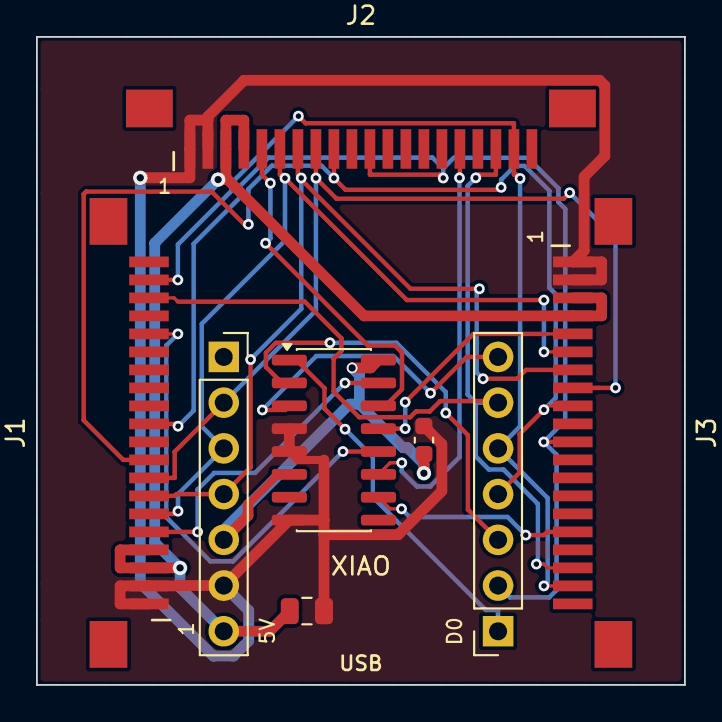
[picture p5: board hub3.kicad_pcb from above]

Board: 2 copper layers, 36.0 x 36.0 mm, 9 parts (0 on the bottom side), 19 nets.

Parts:
C1: 100nF; C_0603_1608Metric
C2: 10uF; C_0805_2012Metric
J1: LCD0; FFC_1.0mm_20P_Bottom_C132515
J2: LCD1; FFC_1.0mm_20P_Bottom_C132515
J3: LCD2; FFC_1.0mm_20P_Bottom_C132515
J4: XIAO D0-D6; PinSocket_1x07_P2.54mm_Vertical
J5: XIAO D7-5V; PinSocket_1x07_P2.54mm_Vertical
U1: 74HC138; SOIC-16_3.9x9.9mm_P1.27mm
X1: XIAO; XIAO_ESP32S3_Outline

Connections:
+3V3: C1.1, J5.5, U1.6, U1.16
+5V: C2.1, J1.3, J1.4, J2.3, J2.4, J3.3, J3.4, J5.7
BL_CTRL: J1.9, J2.9, J3.9, J4.4
GND: C1.2, C2.2, J1.1, J1.2, J2.1, J2.2, J3.1, J3.2, J5.6, U1.4, U1.5, U1.8
LCD_CS0: J1.16, U1.12
LCD_CS1: J2.16, U1.11
LCD_CS2: J3.16, U1.10
LCD_DIN: J1.18, J2.18, J3.18, J4.6
LCD_SCLK: J1.19, J2.19, J3.19, J4.5
LCM_RESET: J1.11, J2.11, J3.11, J4.2
LCM_SCLK: J1.8, J2.8, J3.8, J5.2
LCM_SCS0: J1.5, U1.15
LCM_SCS1: J2.5, U1.14
LCM_SCS2: J3.5, U1.13
LCM_SDI: J1.7, J2.7, J3.7, J5.4
LCM_SDO: J1.6, J2.6, J3.6, J5.3
SEL_A: J4.1, U1.1
SEL_B: J4.3, U1.2
SEL_C: J4.7, U1.3
