yuiseki/exp-cubic-earth/(commit log)

2026-10-15 Bring up LT7680A-R and an ST7701S 480x480 panel from a XIAO ESP32-S3
    Probes and bring-up sketches for the large cubic-earth display:
    LT7680 SPI probe, net finder for the breakout's FFC wiring, LT7680
    PLL and SDRAM init, and a colour-bar test that lights the
    ER-TFT040-3 panel through an ER-PCBA5981-1 controller board.
    WIRING.md records the confirmed wiring and what went wrong on the way.
    Claude-Session: https://claude.ai/code/session_01QQqL2MiTqB6ZDq8JiNUdWg
    [lt7680_backpower.ino, lt7680_bootprobe.ino, lt7680_colorbar.ino, lt7680_init.ino, lt7680_probe.ino, lt7680_vendor.ino, netfinder.ino]
2026-10-15 Fill the display RAM with solid colours through the LT7680 draw engine
    lt7680_fill sets up the main window, canvas and active window as the
    vendor demo does, then fills the whole 480x480 screen with red, green,
    blue, white and black in turn. Each full-screen fill takes about 3 ms.
    All five colours appeared in the right order on the panel.
    lt7680_vendor drives the panel init lines on D6/D7, separate from the
    LT7680 SPI bus, which is what made the colour bar appear.
    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
2026-10-15 Write pixels into the LT7680 display RAM in bursts and read them back
    lt7680_pixels draws a full-screen test pattern through the memory data
    port, sending one 0x80 prefix followed by 64 bytes at a time. That is
    about 30 times faster than the vendor demo's prefix-and-CS per byte.
    A few pixels are read back and compared with the pattern.
    At 10 MHz the panel stopped showing anything and stayed black until a
    power cycle, even after an ST7701S software reset. At 1 MHz it keeps
    working, so the pixel clock stays at 1 MHz for now (4.1 s per screen).
    The panel init now starts with a page-0 select and a software reset.
    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
    [lt7680_pixels.ino]
2026-10-15 Initialise the panel only on power-on, and add a serial command shell
    lt7680_shell takes one-letter commands after a '#' (reset and init the
    LT7680, init or soft-reset the panel, invert, fill, backlight, status).
    Commands need the '#' so that a host tty echoing the board's own output
    cannot trigger them, which happened when the port was reopened.
    Re-sending the ST7701S init to a panel that is already running, after a
    XIAO-only reset, often left it black (recoverable by a soft reset and
    init while the LT7680 drives pixels) or stuck on a pale frame that took
    no commands until a power cycle. The shell now sends the panel init only
    when esp_reset_reason() is power-on. With the panel left alone,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
    [lt7680_fill.ino, lt7680_pixels.ino, lt7680_shell.ino]
2026-10-15 Record that the panel does not come up reliably, and add the vendor-flow sketch
    lt7680_vendorflow copies the vendor demo's setup() and loop() (PLL,
    SDRAM, timing registers, ST7701S init, display on, colour fills) with
    only the pin assignment, a 1 MHz SPI clock and the backlight pin
    changed. It still showed nothing on 4 of 4 power cycles and 5 of 5
    XIAO-only resets, after one flash that did come up.
    lt7680_shell gained commands for the experiments (float lines, wait
    between LT7680 and panel init, fill black/white for camera checks) and
    now waits 8 s after boot before initialising, which did not help.
    WIRING.md records what was tried, what made no difference, and the
    camera-based check used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
    [lt7680_shell.ino, lt7680_vendorflow.ino]
2026-10-15 Draw a QSC earth face on the panel, and send the panel init sequence twice at boot
    Experiments E1-E12 (tmp/HYPOTHESES.md) showed that when the panel SCLK
    line floats during the XIAO bootloader, a single ST7701S init sequence
    afterwards only takes about a third of the time; sending it twice took
    8/8. lt7680_earth builds on the shell with that boot flow and a `#E`
    command that streams a 480x480 RGB565 QSC face through the memory data
    port. lt7680_panelread confirms LCD_DIN is write-only on this breakout.
    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
2026-10-15 Run the whole LT7680-to-panel init flow twice at boot
    After a XIAO reset the first flow (LT7680 hard reset, PLL/SDRAM,
    display on, fill, ST7701S SWRESET + init) never brought the panel up
    (0/8), while the same flow issued later as a serial command did about
    80% of the time. Running the flow twice at boot came up 10/10 across
    esptool resets; the doubled panel init inside each flow is secondary
    (4/5 with a single init). BOOT_FLOWS and BOOT_PANEL_INITS control it.
    Also adds the #F0-#F7 boot-mimic commands and a boot-time IO_MUX dump
    used to rule out reset-time pull-ups.
    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
    [lt7680_earth.ino]
2026-10-15 Add docs/STATUS.md with the verified facts, and use one boot flow on power-on
    docs/STATUS.md lists only what has been confirmed: wiring, what the
    LT7680 and ST7701S paths do, the earth face rendering, tooling, and the
    measured boot success rates. Power-on still does not come up reliably
    with either one or two boot flows (0/3 each, observed by the owner);
    the reset-reason switch stays in as the current best guess.
    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
    [lt7680_earth.ino]
2026-10-15 Log the one150 reproducibility test: 1/3 on cold boot, not a boot sequence candidate
    Same binary, cold boot, one init flow at t=0, 150 s of silence, the
    same flow at t=150 s: LIVE 1/3 (one further trial unjudged because the
    webcam dropped off USB). The LT7680 side was identical in every trial.
    Per the pre-set rule, no threshold search follows. Also adds flow
    start/STSR logging to the diag boot path and a configurable schedule.
    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
2026-10-15 Try a POR self-restart before panel init: 0/3 on cold boot
    On power-on the firmware now optionally waits 2 s, calls esp_restart()
    and runs the normal two-flow init on the software reset
    (BOOT_POR_SELF_RESTART). Three cold boots all stayed black although
    the restart happened each time, so a warm reset of the XIAO alone does
    not make the ST7701S init take right after power-on.
    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
    [lt7680_earth.ino]
2026-10-15 Add lt7680_multi: board-selection abstraction for driving several panels
    Carries the LT7680/ST7701S driver from lt7680_earth and routes every
    chip select through selectLine(), with two wirings: the current direct
    one (LCM_SCS on D0, LCD_CS on D2) and a 74HC138 decoder (A0-A2 on
    D0/D2/D6, Y0-Y2 = LCM_SCS, Y3-Y5 = LCD_CS, Y7 = none) for up to three
    boards. Verified on the single panel in direct mode: boot draws the
    earth, #W fills white, #E redraws. The 74HC138 build compiles only;
    the shared-MISO question is documented as unverified.
    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
2026-10-15 Overlay the ISS ground track on the earth face
    Adds a #Q command (one line "x y w h color") that fills a rectangle,
    a host script that propagates the ISS TLE with SGP4 and projects the
    track with the same QSC projection as the face, and a paced serial
    sender. Verified on the panel: the track crosses the face as a dotted
    arc with the current position marked.
    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
2026-10-16 Record vendor answer: panel RST is an on-board RC reset (R9 10k, C27 1uF)
    BuyDisplay confirmed that CON2 pin 6 (ST7701S RESX) is driven only by an
    RC reset on ER-PCBA5981-1 and is not connected to LCM_RESET. The vendor
    recommends waiting 20-30 ms after power-on before initializing the
    ST7701S, which the current firmware already exceeds.
    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
2026-10-16 lt7680_multi: add BOOT_MINIMAL vendor-order cold boot
    With BOOT_MINIMAL the sketch follows the vendor demo order once: wait
    until 30 ms after power-on (panel RC reset), LT7680 reset and init,
    a single ST7701S init without SWRESET, then display on and the earth
    face. No extra settle delay and no repeated flows. The default build is
    unchanged.
    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
    [lt7680_multi.ino]
2026-10-16 lt7680_multi: add #P to probe external pulls on panel SPI lines
    LCD_CS, LCD_SCLK and LCD_DIN all follow the internal pull-down and
    pull-up, so the board has no strong external pull on them and they float
    from power-on until setup().
    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
2026-10-16 Note owner observation: current firmware shows the earth on about 1 in 3 cold boots
    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
2026-10-16 Root cause of unreliable cold boot: LCD_CS was not connected
    The D2 to CON1 pin 16 (LCD_CS) wire was missing, leaving the ST7701S
    chip select floating. With it connected, the panel comes up on every
    USB-C power-on (owner observation). Boot statistics gathered while the
    wire may have been missing are marked as not to be relied on.
    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
2026-10-16 Record BOOT_MINIMAL cold boots with LCD_CS connected: 3/3
    The vendor-recommended single init now works on power-on as well, so the
    repeated flows were only masking the floating chip select.
    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
2026-10-16 Rewrite WIRING.md for the wiring that works now
    One table for the current XIAO to CON1 wiring, the vendor boot order
    that works with LCD_CS connected, and the pitfalls, with the missing
    LCD_CS wire first. Drop the boot-flow notes that came from the period
    when LCD_CS was not connected.
    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
2026-10-16 Pixel bursts at 10 MHz work with LCD_CS connected
    PIXEL_SPI_HZ is now a build flag. At 10 MHz a full 480x480 face takes
    776 ms instead of about 4.1 s, and ten draw-and-white cycles all showed
    correctly. The earlier 10 MHz failure was observed while LCD_CS was not
    connected.
    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
    [lt7680_multi.ino]
2026-10-16 Test pixel bursts at 20 MHz and add a full-frame readback check
    20 MHz writes a face in 588 ms and shows correctly. The new #V command
    reads the whole display RAM back at 1 MHz and compares it with the face;
    a handful of single-bit errors appear at 1, 10 and 20 MHz alike, and
    they grow with each readback but not with idle time. #S<MHz> switches
    the pixel SPI clock at runtime. The SDRAM refresh interval now matches
    the vendor code (486); it made no visible difference.
    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
    [lt7680_multi.ino]
2026-10-16 lt7680_multi: make the vendor boot and 20 MHz pixels the default
    Boot now waits 30 ms for the panel RC reset, then initializes each
    board's LT7680 and ST7701S once in the vendor order and draws the earth,
    about one second from power-on. Pixel bursts default to 20 MHz. The old
    1.5 s wait plus two flows stays behind BOOT_LEGACY_FLOWS. Also fix the
    74HC138 build, which broke when #P used the direct-mode LCD_CS pin.
    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
    [lt7680_multi.ino]
2026-10-18 Confirm 74HC138 board select on hardware with one board
    Document the TC74HC138AP wiring (A/B/C from D0/D2/D6, Y0 to LCM_SCS,
    Y3 to LCD_CS) and record that the default lt7680_multi build boots and
    shows the earth through the decoder.
    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
2026-10-18 Confirm two boards through the 74HC138
    Both LT7680s answer with STSR=0x54 while sharing LCM_SDO, and each
    panel can be filled independently (white/black swap verified by camera).
    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
2026-10-18 Record 3/3 USB-C cold boots with two boards
    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
2026-10-18 Draw a different cube side face on each board
    Generate the four equatorial QSC faces (90 degrees apart, starting at
    Tokyo) into earth_qsc480x4.h and draw face b on board b, so adjacent
    boards show adjacent sides of the cube. Two boards verified by camera.
    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
2026-10-18 Add #F to draw any side face on the selected board
    Placing board 1 left of board 0 and drawing face 3 there shows India
    continuing into Southeast Asia across the seam (checked by camera).
    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
2026-10-18 Assign any of the six cube faces to each board with x,n
    Generate the north and south pole faces alongside the four side faces
    (make_qsc_faces.py --poles) and let a serial line 'x,n' put face n on
    board x. The choice is stored in NVS so the board boots with it.
    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
2026-10-18 Split the docs into the one-board direct setup and the two-board 74HC138 setup
    WIRING.md now has a shared section plus one section per configuration,
    with the full 74HC138 wiring for both boards. The lt7680_multi README
    gives the build flags and the verified results per configuration.
    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
2026-10-18 Add #I to re-initialise only the selected board
    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
2026-10-18 Add #L to change the register SPI clock
    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
2026-10-18 Document the three-board 74HC138 setup
    Add configuration 3 (Y2 and Y5 to board 2) to WIRING.md and the
    lt7680_multi README, with the verified results (3/3 USB-C cold boots,
    40/40 clean status reads on every board) and the board 2 instability
    seen right after wiring it, which stopped after its lines were reseated.
    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
2026-10-18 Record the measured three-board boot time
    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
2026-10-19 Record panel and controller board dimensions from the vendor STEP
    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
2026-10-19 Add simulate: assemble the cube from two corner modules as 3MF
    Split the vendor STEP into panel and board meshes in the panel frame,
    fold the board onto the panel back as measured (20 mm from the FPC
    edge), and place the six faces as two identical corner modules, the
    second turned half way round. Reports the smallest overlap-free edge
    and where each FFC leaves.
    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
2026-10-19 simulate: triangular board in each module's corner
    Model a board square to the cube's diagonal inside each corner, find
    the largest triangle that clears the panels, boards and FPCs at a given
    depth (separating-axis test against the part boxes), and draw it in the
    3MF with --corner.
    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
2026-10-19 Add hub3: XIAO + 74HC138 + three FFC connectors on a 42 mm board
    A generated KiCad 10 project for the three-board setup (WIRING.md,
    setup 3): the XIAO ESP32-S3 in pin sockets with its USB-C on the free
    side, a 74HC138 picking each board's two chip selects, and a BOOMELE
    1.0-20P bottom-contact FFC connector on each of the other three sides.
    make.py writes the schematic and the placed board from one table,
    route.py routes it with Freerouting, and check.sh passes ERC, DRC with
    the schematic parity check, and a netlist test against WIRING.md.
    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
    [hub3.kicad_pcb, hub3.kicad_sch]
2026-10-19 hub3: route until clean, and write the JLCPCB files
    Freerouting gives a different routing each run and now and then leaves
    an island, a gap or a long neck on a power track, so route.py routes
    again in a fresh process until KiCad's DRC is clean and the +5V and
    +3V3 necks add up to 5 mm or less. GND pads join the pours directly.
    fab.py writes the Gerbers, drill files, BOM and placement from the
    board's lower left corner. Record why the FFC pin order is 1 to 1.
    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
    [hub3.kicad_pcb, hub3.kicad_sch]
2026-10-19 hub3: use the Ckmtw C132515 FFC connector, 44 mm board
    C132515 has JLCPCB's own EasyEDA footprint, so the pads come from it
    rather than from pixels of a drawing. Its body is 2.5 mm longer, so the
    board grows to 44 mm to keep the corners clear. Move the 10 uF next to
    the XIAO 5V pin.
    route.py now starts each attempt from an unrouted copy that make.py
    leaves in build/ with the project beside it (without it pcbnew used the
    default net classes and saved them over the project), and when an
    attempt is not clean it makes the board again: Freerouting routes the
    same DSN the same way whatever its options, but each make.py run gives
    a different DSN. Allow 7.5 mm of necked power track, about 2.5 mm pe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
    [hub3.kicad_pcb, hub3.kicad_sch]
2026-10-19 hub3: turn the SOIC-16 by -90 degrees in the JLCPCB placement file
    JLCPCB's preview showed the 74HC138 standing on end with pin 1 at the
    lower right at KiCad's 90 degrees; at 0 it lies like its pads with pin
    1 at the lower left.
    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
2026-10-19 hub3: one BOM row per LCSC part
    J1-J3 went in as three rows (one per LCD name) and JLCPCB's merged BOM
    came back with nine designators for C132515. Write each LCSC part once,
    with all its designators.
    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
2026-10-19 hub3: keep commas out of the BOM comments
    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
2026-10-19 hub3: assemble the XIAO's two pin sockets too
    Replace the XIAO footprint with two 1x7 2.54 mm female sockets (J4, J5,
    XFCN PM254V-11-07-H85, LCSC C2832270) for JLCPCB to fit. The XIAO
    stays on the schematic but off the board; a board-only outline marks
    where it sits and which row is D0 and which 5V. The placement file
    gives the sockets' pad centre, since their origin is on pin 1. A test
    checks the rows are 15.24 mm apart with D0 and 5V at the USB end.
    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
    [hub3.kicad_pcb, hub3.kicad_sch]
2026-10-19 hub3: turn the pin sockets by 90 degrees in the JLCPCB placement file
    JLCPCB's preview showed both 1x7 sockets lying across the board at
    KiCad's 0 and 180 degrees.
    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
2026-10-20 hub3: the FFC pin order does not depend on how the cable is routed
    A cable with its contacts on the same face at both ends only makes
    contact one way round in a bottom-contact connector, so it cannot be
    flipped into a 21-n order; only a cable with contacts on opposite faces
    would reverse it.
    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
2026-10-20 docs: add the panel's active area and dot pitch from its datasheet
    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
2026-10-20 lt7680_multi: skip boards that are not connected
    With fewer boards connected than NUM_BOARDS, MISO floats for the
    missing ones. If it reads high, the write-FIFO wait in drawFace never
    ends and the backlight is never switched on, so even the connected
    boards stay dark. Skip boards whose LT7680 init timed out and give the
    FIFO wait a 100 ms limit. Builds for NUM_BOARDS=1 and 3; not yet tried
    on hardware.
    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
    [lt7680_multi.ino]
2026-10-20 Turn each board's earth face by quarter turns
    lt7680_multi: x,n,r assigns face n to board x turned r quarter turns
    clockwise and saves the turn with the face. simulate: earth_turns gives
    each cube face its QSC face and turn for a plan.
    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
2026-10-20 WIRING: note which XIAO pins reach the Sense expansion board
    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
2026-10-20 WIRING: the Sense microSD's CS is GPIO21, not D2
    The expansion board schematic fits R12 (0R) to GPIO21 and leaves R11 to
    D2 unfitted, and pulls MISO, MOSI and CS up with 4.7k.
    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
2026-10-20 WIRING: add Seeed's note on the Sense microSD and the J3 pad
    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
2026-10-20 WIRING: record the Sense boot failures with the expansion board on
    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
2026-10-20 WIRING: the Sense boots all three boards with the expansion board back on
    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
2026-10-20 lt7680_multi: draw a region of a face, and time moving a marker
    drawRegion writes any rectangle of a face (with the board's turn);
    drawFace is now the whole-face case. #T moves a red square along the
    middle row, redrawing the face under its last place each frame, and
    reports ms per frame.
    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
2026-10-20 lt7680_multi: planes and ships cross the seams between faces
    Movers keep a position on the sphere and travel along great circles.
    qsc.h projects each one to its face and pixel every frame, and it is
    drawn on whichever board shows that face, turned with the board.
    qsc.h is a port of host/qsc.py, which is checked against PROJ; the C
    port is checked against points from the Python one.
    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
2026-10-20 lt7680_multi: labels for the demo movers, south down
    #D takes a label flag and a plane count. Labels are drawn in a 5x7
    font (from X11 misc-fixed) with the local south at the bottom of the
    letters. Only movers overlapping a region are checked per pixel, and
    drawRegion leaves the window narrowed until fillRect needs it full.
    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
    [lt7680_multi.ino, make_font5x7.py, mover.h]
2026-10-20 lt7680_multi: #G, a double-buffered version of the demo
    Pages 0 and 1 in display RAM are front and back, page 2 holds the
    face and the pages after it the sprites. Each frame erases with a BTE
    copy from page 2, draws sprites with a chroma-keyed BTE copy, and flips
    the main image start address. The new address only takes effect at the
    next VSYNC, so the old page is left alone until the VSYNC flag is set;
    touching it straight away made the markers flicker.
    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
    [lt7680_multi.ino, mover.h]
2026-10-20 lt7680_multi: #G keeps 30 fps with 150 planes
    Write the 74HC138 address through the GPIO set/clear registers, hold
    the SPI bus at 10 MHz for a frame's register traffic, skip BTE register
    writes that would not change, and do each board's wait, erase, draw and
    flip together so the VSYNC waits overlap. 162 movers with labels take
    29 ms a frame.
    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
    [lt7680_multi.ino, mover.h]
2026-10-20 lt7680_multi: erase a plane's old sprite after it changes boards
    The per-board pass overwrote a mover's record of where it was drawn on
    the back page when it drew it on its new board, so the board it had
    left never erased the old sprite. That sprite stayed on one page only
    and blinked at the seam every other frame. Take the rectangles to erase
    before the pass. #G also reports how often a sprite lands near the
    panel edge (6.5% here, as expected for planes spread evenly).
    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
2026-10-20 lt7680_multi: a flip-book of the last 24 hours of clouds
    host/clouds_hourly.py lays SSEC RealEarth's hourly global infrared over
    the Blue Marble and cuts each board's face, already turned. #R streams a
    frame straight into a page of the board's display RAM, and #M plays the
    pages by flipping the main image address.
    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
    [clouds_hourly.py, lt7680_multi.ino, send_frames.py]
2026-10-21 simulate: call the corner module the summit type (山頂型)
    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
2026-10-21 lt7680_multi: probes that found the display RAM wraps at 8MB
    #Z writes a marker in every 512KB slot, #Y checks a page is kept, #X
    dumps a page (host/dump_page.py). PAGE_STRIDE and SDRAM_E0 can be set
    at build time to try other layouts.
    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
2026-10-21 simulate: summit frame, three slotted rails joined at the module's corner
    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
2026-10-21 simulate: a thick beam inside each seam of the summit frame
    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
2026-10-21 simulate: stop the summit frame's walls and beams at the third panel's back
    They ran on past the corner and stood 1mm proud on that panel's glass,
    a square step inside the lips' corner.
    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
2026-10-21 simulate: the summit frame as three identical mitred bars, printed flat
    A Y joined at the corner needs a print about 80mm high, and printing is
    charged by volume. The module turns into itself round its corner, so the
    three bars are one bar (and the other module's too): one design, six
    prints, 82.7 x 7.5 x 7.5 each. The beam goes, for volume too.
    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
2026-10-21 Overlap the panels at the summit corner (pinwheel) and thin the lips
    Round the first module's corner each panel reaches the cube's edge toward
    the panel before it and tucks behind the one after it, so no gap is left
    between the panels at the summit seams: the cube goes from 81.69 to
    79.12mm glass to glass. The summit frame's lips (0.6mm) stand only in
    front of their own panel's glass; the tucked panel's lip also covers the
    side of the panel that reaches the edge. A bar is now 0.46cm3.
    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
2026-10-23 hub3: shrink to 36 x 36 mm with the 74HC138 under the XIAO, no holes
    J1 and J3 sit below J2's strip, so the width is set by the two side
    connectors and the XIAO's sockets, not by J2's length. The 74HC138 and
    both capacitors move between the socket rows. Still two layers, one side.
    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
    [hub3.kicad_pcb, hub3.kicad_sch]
2026-10-28 hub3: same-side FFC cables reverse the pin order (n to 21-n), found on rev B
    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
2026-10-28 hub3: rev B works with FFC cables that have their contacts on opposite faces
    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
2026-10-28 lt7680_multi: #V compares against the face as drawn, with the board's rotation
    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
2026-10-28 lt7680_multi: drive SCK and MOSI at strength 1; at the default 2 hub3's J1 corrupts pixels
    Board 0 on hub3 (J1, 7 mm from the XIAO on a daisy-chained bus) got
    pixels shifted by one bit at 20 MHz with the default drive strength 2.
    Strengths 1 and 3 read back clean on all three boards. #H<0-3> sets it.
    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
2026-10-28 lt7680_multi: #C mounts the Sense expansion board's microSD on the shared SPI and times a face
    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
2026-10-28 Switch faces over ESP-NOW: espnow_bridge broadcasts USB lines, lt7680_multi runs them as commands
    lt7680_multi now needs the max_app_8MB partition (the baked earth plus
    Wi-Fi no longer fit in 3.3 MB); nvs stays where it was.
    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
    [byte_ring.h, espnow_bridge.ino, lt7680_multi.ino]
2026-10-28 Scenes on the microSD switched over ESP-NOW (#s, #e, #w, send_scene.py), plus radio diagnostics
    #s<k> draws /scenes/<k>/face<f>.bin on every board with its face and
    rotation. #e exports the baked earth, #w (host/send_scene.py) writes
    faces over USB. #a scans Wi-Fi, #p pings over ESP-NOW, #r counts packets;
    the bridge reports delivery, unicasts with !MAC and scans with ?. Without
    the XIAO's antennas the link failed both ways.
    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
    [espnow_bridge.ino, lt7680_multi.ino, send_scene.py]
2026-10-28 Planes, ships and the ISS over a microSD scene: #s loads into the face overrides, scene_iss.py draws the track
    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
2026-10-28 espnow_bridge: battery_watch.py logs ACKs and pings from a battery-powered cube
    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
2026-10-28 host: scene layers for railways, rivers (tile.yuiseki.net), airports and population
    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
2026-10-28 simulate: summit bars with two slots that do not meet, and a corner bracket inside
    Each summit seam gets a 6.88 mm square bar with a 2.38 mm slot per panel;
    the slots stop 1 mm apart so the bar stays whole. The bar ends mitre into
    the outer vertex; behind the panels a tetrahedral bracket with pockets for
    the bars' back walls holds the three ends at 90 degrees.
    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
2026-10-28 simulate: a corner joint, the summit bars cut to 20 mm arms round the vertex as one piece
    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
2026-10-28 simulate: straight long bars carry on from the corner joint's arms
    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
2026-10-28 simulate: cube_frame.py, corner joints on all 8 vertices and slotted bars on all 12 edges
    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
2026-10-28 cube_frame: one bar shape and one joint shape, print STLs laid flat, no CAD for the flexible FPC and FFC
    Slots are cut to their full depth whatever the panel's size, so the 12
    bars are the same and the 8 joints are the same.
    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
2026-10-28 hardware/frame: print STLs for the frame, one corner joint (x8) and one slotted bar (x12)
    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
    [bar.stl, joint.stl]
2026-10-29 host: equirect_scene.py puts any equirectangular image on the six faces
    clouds.sample now reads the image size from the image, and scene_compose
    writes its faces through equirect_scene.write (same bytes as before).
    --west names the longitude at the image's left edge (0 for NIPR's Dagik
    images, 180W for the Dagik Earth zips).
    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
2026-10-29 battery_watch: watch several modules at once, ACK and ping per MAC
    The log path now comes before the MACs. No firmware change: the bridge
    prints rx <MAC> for every ping, so each module's answer is told apart.
    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
2026-10-29 docs/STATUS: both modules re-laid, current edges and face assignment
    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
2026-10-29 STATUS: module 1 re-layout, stripes after #I and on module 1 board A at 20 MHz
    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
2026-10-29 STATUS: module 2 stalls in #G on the round power bank, fine on USB
    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
2026-10-29 STATUS: module 1 board A stripes were the power bank, stable at 20 MHz on USB
    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
2026-11-03 #G: read back LT7680 registers each second and report mismatches per board
    Boards drew noise, sprite sheet and diagonal smears during #G while BTE
    still answered; the display start, chroma key or BTE widths looked
    corrupted. reg_verify.h compares the fixed registers and the regCache
    view with a read-back, reading twice to tell a chip value from a bad read.
    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
    [lt7680_multi.ino, reg_verify.h]
2026-11-03 SPI_DRIVE 3: #G face breakage was the SCK/MOSI drive strength, not power
    With drive 1, register read-back during #G showed corrupted LT7680
    registers (chroma key, BTE widths) within seconds at 10 MHz and BTE
    hangs, on any power source and with the backlight off. Drive 3 gave
    0 bad reads in 549 checks over a 10 minute soak; drive 0 broke all
    boards. Record the comparison in STATUS and README.
    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
    [lt7680_multi.ino]
2026-11-03 STATUS: the 10-29 power explanations were wrong, square power bank runs #G fine at drive 3
    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
2026-11-03 STATUS: square power bank ran #G on both modules for 10 minutes without breakage
    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
2026-11-03 Turn the backlight off when idle, only while a USB host is attached (#i)
    Left plugged into pi4-deck for flashing and logs, a module (about 4 W)
    drained the deck's battery until it shut down. With a host on the USB
    (SOF seen within 3 s), the backlight goes off after #i minutes without
    commands (default 10, saved in NVS) and comes back on with the next
    command. On a power bank or AC adapter there is no host, so an
    exhibition never goes dark.
    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
2026-11-03 STATUS: idle backlight off works on a USB host and stays on with a power bank
    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
2026-11-03 STATUS: two square power banks, one per module, fit inside the closed cube
    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
2026-11-03 send_scene: wait for the shell if opening the port reset the XIAO, keep DTR/RTS on close
    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
    [send_scene.py, test_send_scene.py]
2026-11-03 send_scene: probe the shell with #r before the first #w
    A XIAO just plugged in is still booting; the #w sent then lost its '#'
    and the rest was read as a face assignment. Waiting for a boot banner
    did not help, since nothing reaches the host before it enumerates.
    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
2026-11-03 Face assignment only through #f<board>,<face>[,<turn>]
    A bare x,n,r used to be accepted. On 2026-11-03 a #w200,1 sent while
    the XIAO was still booting lost its '#', and what was left rewrote a
    board's face in NVS. Bare digit-comma input is now reported and ignored.
    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
2026-11-03 Join the same Wi-Fi APs as the bridge at boot and fetch side images with #j
    All devices join the first visible AP of secrets.h (gitignored; home
    and a phone hotspot), so ESP-NOW rides that AP's channel, as in
    expt-the-map-runs. With no AP, ESP-NOW stays on channel 1. #m<name>
    stores the module name; #j fetches <WEB_BASE>/<name>-side-a/b/c.jpg
    (480x480 JPEG, JPEGDEC) and draws them on boards A-C as they are.
    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
2026-11-03 #j: add ?t=<millis> so a replaced image is not served from Cloudflare's cache
    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
    [lt7680_multi.ino]
2026-11-03 STATUS: all three devices join the AP list; #j draws the web side images on all six panels
    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
2026-11-04 Sample airliner positions every N minutes from adsb.lol globe_history
    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
2026-11-04 Bridge ocean gaps in airliner traces along great circles
    Receivers are on land, so a Pacific or Atlantic crossing is seen only at
    both ends. With --fill, times inside one cruise gap (no new leg, implied
    250-650 kt, under 16 h) get a great-circle position marked filled.
    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
2026-11-04 Replay a real day of airliners on the cube (#t), refreshed from the web (#J)
    flights/pack_flights.py packs globe_snapshots output into a CEF1 file
    (15-minute keyframes of every picked flight, capped per cube face).
    The module keeps it on microSD and loads it into PSRAM; #t drives the
    #G double buffer with those flights, interpolating between keyframes.
    #J downloads <WEB_BASE>/flights.bin to a temp file and swaps it in only
    when the header and length check out. Also fixes old format warnings.
    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
    [flight_track.h, lt7680_multi.ino, mover.h]
2026-11-04 Real ships from aisstream: hourly windows, daily ships.bin, #t draws them
    collect_ais.py listens worldwide for a few minutes each hour and keeps the
    latest fix of every moving ship; daily_ships.py turns a UTC day of those into
    the same CEF1 file the planes use (pack_flights.py, capped per face). #t now
    also loads /flights/ships.bin and moves the ships as white dots on the same
    clock, and #J fetches ships.bin next to flights.bin.
    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
    [flight_track.h, lt7680_multi.ino]
2026-11-04 Status: planes and ships on the assembled cube
    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
2026-11-05 Draw #t planes as plane icons turned to their heading, ships as ship icons
    icons.h holds an 11x11 plane (upright and diagonal, the other six turned by
    quarter turns) and a side-on ship. The heading comes from where the plane
    will be half a keyframe later, projected to panel pixels, so it is right on
    every face and board turn. Nine sprite blocks are drawn once per run.
    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
2026-11-05 Record icon frame times and the first daily ships.bin over #J
    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
2026-11-05 Record the printed corner joints holding the six panels
    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
2026-11-05 Add a year of daytime land surface temperature as 24 scenes
    lst_year.py turns the half-monthly normal of Aqua MODIS daytime LST,
    as JAXA Earth hosts it, into six faces per half-month with a fixed
    colour scale and a legend on face 1; play_scenes.py flips through
    microSD scenes over the ESP-NOW bridge.
    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
    [lst_year.py, play_scenes.py, test_lst_year.py, test_play_scenes.py]
2026-11-05 Add named scenes and #v to play a dated range of them in a loop
    #w now takes a scene name as well as a number, and #v<set>,<from>
    [,<to>[,<sec>]] shows the dated frames of /scenes/<set>/ in range,
    looping when a range is given, until the next command arrives.
    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
2026-11-05 Document named scenes, #v and the Shikisai LST frames on both modules
    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
2026-11-05 Let battery_watch.py pick a heavy drawing load at random each cycle
    --loads picks from real planes and ships (#t), made-up ones (#G),
    Shikisai scenes from the microSD (#v) and web pictures over Wi-Fi
    (#j), and the CSV gains a load column.
    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
2026-11-05 Record the battery run under random heavy loads and wait longer for pings
    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
2026-11-05 docs: TE-0012 battery passes power through while charging overnight
    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
2026-11-05 docs: per-module current with and without backlight
    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
2026-11-05 Add #z to put radio, LT7680, panels or CPU into power saving one at a time
    For measuring what draws the remaining 0.4 A with the backlight off.
    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
2026-11-06 docs: battery run with TE-0012 plus a 10000 mAh pack passing power through
    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
2026-11-08 cube_frame: CUBE_FRAME_DEPTH and CUBE_FRAME_BUILD to try a deeper slot without touching the default parts
    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
2026-11-08 hardware/frame: joint-deep.stl and bar-deep.stl, slot 1.0 mm deeper
    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
    [bar-deep.stl, joint-deep.stl]
2026-11-08 tests: clouds.py and clouds_hourly.py offline, and guard tests for the frame print STLs
    The seam and Mercator tests were checked by breaking the code and watching them fail.
    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
    [test_clouds.py]
2026-11-09 iss_track.py: split into functions that do nothing on import, with offline tests
    A TLE fixture and golden output recorded from the old script (frozen time)
    check that the split changed nothing. Mutations of the projection, the
    GMST, the colours and the cache were each caught.
    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
    [iss_track.py, test_iss_track.py]
2026-11-09 lt7680_multi: read the earth from the microSD's /earth instead of baking it in
    The baked earth was 2.64 MB of the 3.7 MB app. Without it the app is 1.07 MB and fits an OTA slot
    of default_8MB (3.19 MB). Boot now shows a name card (unit name from the MAC, the board letter,
    CUBIC-EARTH, edge numerals 1-4), then loads /earth/face0-5.bin into PSRAM. #u reloads it; #e is gone.
    The scene name "earth" maps to /earth, so send_scene.py writes it as before. host/earth_header.py makes
    the six face files from the old header. Not yet run on the modules.
    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
